boxforkonstantin-max/guitar-stand/DESIGN.md

# Design system

## Direction

Верстак точного столяра при нейтральном дневном свете: темный графит инструмента, холодный синий измерений, фанера как реальный материал модели. Интерфейс плотный и рабочий, без декоративных карточек и рекламных блоков.

## Tokens

- Background: `oklch(0.12 0 0)`
- Surface: `oklch(0.18 0.012 230)`
- Raised surface: `oklch(0.23 0.014 230)`
- Ink: `oklch(0.95 0.006 230)`
- Muted: `oklch(0.72 0.018 230)`
- Primary: `oklch(0.64 0.12 230)`
- Accent: `oklch(0.78 0.15 78)`
- Success: `oklch(0.70 0.14 150)`
- Danger: `oklch(0.66 0.19 28)`

## Typography

Один системный гротеск для интерфейса. Табличные числа включают tabular-nums. Основной размер 14 px, подписи 12 px, заголовок инструмента 18 px.

## Layout

Три рабочие зоны: список деталей слева, 3D-сцена в центре, параметры и проверки справа. На узком экране панели переходят под сцену. Холст остается главным элементом.

## Components

- Toolbar: компактные кнопки 36-40 px, явные активные состояния.
- Part row: код, название, размер и видимость без вложенных карточек.
- Inspector: числовые поля в миллиметрах, статус проверки, координаты выбранной детали.
- Canvas: темный нейтральный фон, реальная сетка 100 мм, оси и размерный куб.

## Motion

Только движение камеры, детали и плавный переход взрыв-схемы. Интерфейсные переходы 160-220 мс; при reduced motion - мгновенно.
