boxforkonstantin-max/guitar-stand/DEPLOYMENT.md

# Публикация конструктора

- 12.10.2026 D3: отдельная исправленная компоновка `/ldsp-onstage/d3.html`, не производственный выпуск. D2 отмечен архивным. Публичный корень предлагает D3 и R6 без автоматического перенаправления.
- Three.js 0.170.0 и два controls включены в `vendor/three` с лицензией MIT; сторонний CDN больше не нужен. Геометрия R6 и app.js не изменены, в HTML исправлены загрузка и ссылки.
- `127.0.0.1:8080` — временный просмотр разработчика, не постоянный хостинг. При диагностике 12.10 локальный порт не отвечал. Для передачи преподавателю использовать публичный HTTPS-адрес.

- Репозиторий: https://github.com/boxforkonstantin-max/guitar-stand
- Выбранный бесплатный хостинг: GitHub Pages, ветка main, корень.
- Ожидаемый адрес: https://boxforkonstantin-max.github.io/guitar-stand/
- Публикуются только код приложения и воспроизводимые файлы геометрии. Исходные пользовательские фотографии, приватные документы, секреты и соседние проекты не входят в Git.
- Статическое приложение; рабочих БД и серверного состояния нет. Откат — точный предыдущий Git commit. Изменения положений в браузере локальны и не сохраняются на сервере.
- R6: по просьбе владельца K и Katana возвращены в горизонтальное положение 0°. AIRSTEP центр Z45, прежний наклон 10°, упор U оставлен. Просвет у педали около 123 мм: удобство не подтверждено. Плашка AUX/USB/наушники 3,5 мм остаётся отложенной.
- Геометрия проекта не является допуском к изготовлению: нужно согласовать вентиляцию, крепёж, устойчивость, фактические габариты и эргономику.
