boxforkonstantin-max/guitar-stand/PRODUCT.md

# Product

## Register

product

## Platform

web

## Users

Владелец домашней гитарной установки, который собирает компактную стойку сам или передает файлы столяру/оператору ЧПУ. Основной сценарий - проверить реальную компоновку, осмотреть изделие со всех сторон и подготовить детали к производству.

## Product Purpose

Дать один проверяемый источник геометрии для стойки под Boss Katana-50 MkII, XSONIC AIRSTEP и 13-дюймовый ноутбук: интерактивную сборку в миллиметрах, ведомость деталей и производственные 2D-файлы.

## Brand Personality

Точный, мастерской, спокойный.

## Anti-references

Не имитировать художественный псевдочертеж, не скрывать допущения, не использовать декоративную «инженерную» графику без числовой геометрии, не превращать интерфейс в маркетинговый лендинг.

## Design Principles

- Один набор параметров управляет визуализацией и производственными файлами.
- Размеры, допуски и непроверенные исходные данные видны рядом с моделью.
- Основные действия доступны без обучения: выбрать, двигать, вращать, вернуть в сборку.
- Раскрой считается в миллиметрах и проходит автоматическую проверку границ и пересечений.
- Ошибка модели оборудования должна обнаруживаться до распила листа.

## Accessibility & Inclusion

Клавиатурная навигация, заметный фокус, достаточный контраст, отключение лишнего движения при prefers-reduced-motion. Цвет не является единственным носителем состояния.
