boxforkonstantin-max/guitar-stand/ldsp-onstage/output-d3/hardware.html

← Модель D3

# Без ящика и больших упаковок крепежа

Цены Крепики прочитаны в каталоге 12.10.2026. Резервы подписаны отдельно. Это бюджет для согласования, не подтверждённый заказ и не окончательная спецификация.

Фурнитура с резервами: 2,305.08 ₽. Вся стойка с работами: 13,420.04 ₽. Без доставки и монтажа к стене.

Позиция | Количество | Сумма, ₽
Конфирмат 7×50, внутренний шестигранник (https://www.krepika.ru/catalog/itempage/6725/)1,98 ₽/шт. Цена в каталоге 12.10.2026. | 34 шт. | 67.32
Саморез 4×30, головка со сферой, PZ (https://www.krepika.ru/catalog/itempage/7312/)1273,96 ₽/кг. Масса 0,002 кг/шт. округлена магазином; итог по весам. | 20 шт. ≈ 0,040 кг | 50.96
Рояльная петля 500 мм (https://1levsha.ru/catalog/mebelnaya_furnitura/7020/)Ссылка на товар в Екатеринбурге. 150 ₽ — бюджет, не подтверждённая цена; присадка HOLD. | 1 шт. / резерв | 150.00
Ограничители откидывания, параВыбрать пару под фасад ~0,6 кг; не газлифт для тяжёлой двери. Присадка HOLD. | резерв | 200.00
Магнитный фиксатор с ответной частьюПрисадка после выбора. Не добавлять отдельную выступающую ручку. | 1 компл. / резерв | 100.00
Мягкие привинчиваемые опоры гитары (https://on-stage.com/guitar-workstation-rosewood)Две нижние опоры и верхний ограничитель. Это референс, НЕ ссылка на покупку. Точный аналог ещё не выбран. | 3 шт. / резерв | 1000.00
Липучка UNIBOB 49310, 20 мм × 1 м (https://lipkaya-lenta.ru/katalog/lipuchki-zastezhki/lenta-lipuchka-unibob-kruchok-petlya-samokleyashayasya.html)Ранее найденная цена, повторно не подтверждена. Для педали; к гитаре не приклеивать. | 1 комплект | 232.80
Подпятники / мягкие накладкиЛокальные подпятники, не рулон резины 6 м. На гитаре — совместимое с лаком заводское покрытие. | резерв | 104.00
Малый крепёж петли, фиксатора и держателей (https://www.krepika.ru/catalog/itempage/1575/)3,5×16 потай: 519 ₽/кг; количество и длины определить по фурнитуре, не покупать 250 шт. | резерв поштучно/весом | 100.00
Страховка от опрокидывания (https://www.krepika.ru/catalog/itempage/66196/)Пример местной цены: RDRp 10×160 — 49,98 ₽/шт. НЕ автоматическая замена SXRL: стена и узел не выбраны. | резерв | 300.00

## Материал и работы

ЛДСП 16 мм, целый лист 2500×1830 | 2130.00 ₽
Распил — бюджет, не заказ цеха | 700.00 ₽
Кромление 23,916 м × 60 ₽ | 1434.96 ₽
Материал кромки — резерв | 450.00 ₽
108 сверлений × 25 ₽ | 2700.00 ₽
Ручки, отверстия новой фурнитуры, доводка — резерв | 1200.00 ₽
Сборка и контрольные испытания — резерв | 2500.00 ₽

## Что исключено

Телескопические направляющие и короб ящика; деревянная вилка, её рёбра и боковая платформа; рулон резины; упаковки по 250 шурупов; пакет шайб на 10 штук.

Для сравнения: DIN 9021 М10 — 3,74 ₽/шт. (https://www.krepika.ru/catalog/itempage/1794/); SXRL T 10×160 — 267,89 ₽/шт. (https://www.krepika.ru/catalog/itempage/48521/) (иная головка, чем прежний FUS). Покупать только выбранное исполнение, не смешивать дюбели и шурупы разных систем.

Ручки — сквозные пазы 110×30 мм, без покупной накладной ручки. Обработать и закрыть торец, снять острые кромки.

## Не закрыто до производства

- Присадка петли, фиксатора, ограничителей и держателей не утверждена: не сверлить по 3D.
- Держатели показаны по принципу On-Stage. Материал оригинала и доступный аналог с паспортом не подтверждены.
- Нужны примерка гитары, выбор фурнитуры и испытания узлов. Это компоновка, не выпуск в производство.
- Без страховки от опрокидывания не эксплуатировать; тип анкера зависит от стены.
- Переносить только пустую стойку вдвоём. Вентиляция отложена.

Размеры, механизм и контрольные условия
