boxforkonstantin-max/guitar-stand/ldsp-onstage/output-d2/hardware.html

← Модель D2

# Фурнитура и стоимость D2

Проверка каталогов: 12 октября 2026. Цены без доставки. Это расчёт бюджета, не счёт поставщика.

Фурнитура: 5,308.07 ₽. С изготовлением и целыми розничными упаковками: 19,712.07 ₽. Сценарий цеха с метизами поштучно: 18,382.95 ₽ — предварительно.

Не оферта. Поштучный отпуск W1 не подтверждён. Перед покупкой сверить цену, упаковку и доставку. Ни один заказ не оформлен.

Позиция / ссылка на товар | Нужно | Покупка | Сумма, ₽
SL · BOYARD DB4501Zn/300, пара (https://www.boyard.biz/catalog/slide_systems/db4501zn-300.html)15 кг на пару по текущей карточке. Не 40 кг из старого каталога. В Екатеринбурге наличие не подтверждено. | 1 | 1 пара | 275.97
C7 · Конфирмат 7×50 Timtech (https://www.ozon.ru/product/konfirmat-7h50-mm-10sht-mebelnyy-vint-styazhka-golovka-potaynaya-pod-shestigrannik-evrovint-1317687131/)93 ₽ за 10 шт., цена без специальной банковской скидки; остаток в запас. | 52 | 6 пакетов по 10 | 558.00
S4 · Шуруп по дереву 4×30 PZ2, полукруглая головка (https://letfix.ru/shop/fasteners/screws/screws_for_wood_polukr_yzn_4x30.html)Артикул 106001817. Цеху выгоднее отпустить 28 шт. из своей упаковки; их доля 114,24 ₽. Не заменять головку без изменения чертежа. | 28 | 250 шт. | 1020.00
S16 · Шуруп по дереву 3,5×16 PZ2, полукруглая головка (https://letfix.ru/shop/fasteners/screws/screws_for_wood_polukr_yzn_3-5x16.html)Артикул 106001802. Доля 10 шт. — 17,64 ₽. Проверить зазор головки в направляющей. | 10 | 250 шт. | 441.00
STR · Fortisflex КСВ 16×310 чёрный, 59295 (https://www.radioelementy.ru/catalog/pod-zakaz/styazhka-velkro-ksv-16kh310-chern-fortisflex-59295/)39,89 ₽/шт. Один ремень вилки, восемь для кабелей. Не несущая подвеска гитары. | 9 | 20 шт. | 797.80
VEL · UNIBOB 49310, крючок+петля 20 мм × 1 м (https://lipkaya-lenta.ru/katalog/lipuchki-zastezhki/lenta-lipuchka-unibob-kruchok-petlya-samokleyashayasya.html)2 полосы по 200 мм под AIRSTEP; остальные 600 мм в запас. Не закрывать серийный номер/винты прибора. | 1 | 1 комплект | 232.80
FEL · Pacific РС6055BR, войлок 3 мм, 35×55, 12 шт. (https://amix.biz/catalog/nozhki_mebelnye/podpyatniki_mebelnye/rs6055br/)52 ₽/лист. По 3 накладки на G1/G2, 6 подрезанных накладок по контуру вилки. Стыки без открытой кромки; сначала проба совместимости с лаком. | 12 | 2 листа / 24 накладки | 104.00
RUB · Резиновая самоклеящаяся полоса 29×3 мм, 6 м (https://m.integration.vs.market.yandex.net/card/samokleyashchayasya-rezinovaya-taktilnaya-polosa-protiv-skolzheniya-29-mm-kh-3-mm-tsvet-seryy-dlina-6-metrov/1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)Цена с Яндекс Пэй. 4 полосы 834 мм под E1/E2 (нахлёст по ширине обрезать), 2 по 500 под PF1/PF2. Остаток 1664 мм. Не использовать эту резину на гитаре. | 1 | 1 рулон | 1222.00
W1 · fischer SXRL 10×160 FUS, 522724 (https://fischersystem.ru/catalog/fasadnye_dyubeli/522724/)289,25 ₽/шт. Каталог также указывает коробку 50 шт. за 14 462,49 ₽. Не заказывать коробку ради двух: стоимость 2 шт. условна до подтверждения отпуска. Только узел для бетона C20/25. | 2 | 2 шт. / проверить поштучную продажу | 578.50
W2 · Шайба DIN 9021 M10, оцинкованная (https://www.stroysa.tomsk.ru/catalog/metrika/shayba_din_9021_uvelichennaya_m10_10sht/)78 ₽ без карты; Øнаружный 30, Øвнутренний 10,5, толщина 2,5 мм. Под головками стеновых креплений. | 2 | 10 шт. | 78.00

## Материалы и работы

ЛДСП белый 16 мм, 2500×1830, 1 лист (https://twowin.ru/product/ldsp-16mm-2500kh1830-belyy-0110-resm-kronoshpan/) | 2130.00 ₽
Раскрой 30 деталей ЛДСП 16 мм (https://family96.ru/raspil-ldsp/)Тариф 21–40 деталей; малые W выпиливать из укрупнённой заготовки безопасным способом. | 700.00 ₽
Кромление всех деталей 16 мм (https://family96.ru/raspil-ldsp/)Расчётная оценка: 60 ₽/м; фасонные торцы цех считает отдельно. | 2024.00 ₽
Материал кромки 0,4 мм + герметизация пазовРезерв, не найденная розничная цена. Включить в предложение цеха. | 600.00 ₽
Присадка всех отверстий (https://drevplit96.ru/services/raspil/)Оценка по тарифу от 25 ₽/отверстие, торцевые и зенковки могут стоить иначе. | 4450.00 ₽
Фрезеровка вилки, ручки и трёх пазовБюджетный резерв на ЧПУ/шаблон, не коммерческое предложение. | 2000.00 ₽
Сборка и контрольные испытания образцаРезерв; монтаж анкеров и доставка отдельно. | 2500.00 ₽

## Сборка без лишних покупок

Отдельные ручка, петли, газлифт и доводчик не нужны. Ручка фрезерована в фасаде. Направляющие имеют полный ход и рычаги снятия. Площадка AIRSTEP снимается руками и работает на полу.

Сменная плашка прежней версии удалена: теперь есть нижние опоры гитары, вилка и ремешок. Подвешивать вес гитары к вилке нельзя.

Обязательная страховка от опрокидывания: два анкера через верхнюю заднюю связь и прокладки. Чертёж подходит только для здорового бетона C20/25; для другой стены требуется другой монтажный узел.

Не включены: доставка, монтаж в стену, инструменты/оснастка изготовителя, техника/гитара, необязательные органайзеры.

Чертежи и контрольная сборка · Исходные суммы
