boxforkonstantin-max/guitar-stand/output/guitar_stand_drawings.pdf

# Раскрой двух стоек / 01 · Плавная дуга

Лист 2440 × 1220 × 18. Отступ 6; зазор между габаритами ≥6. Без зеркалирования.

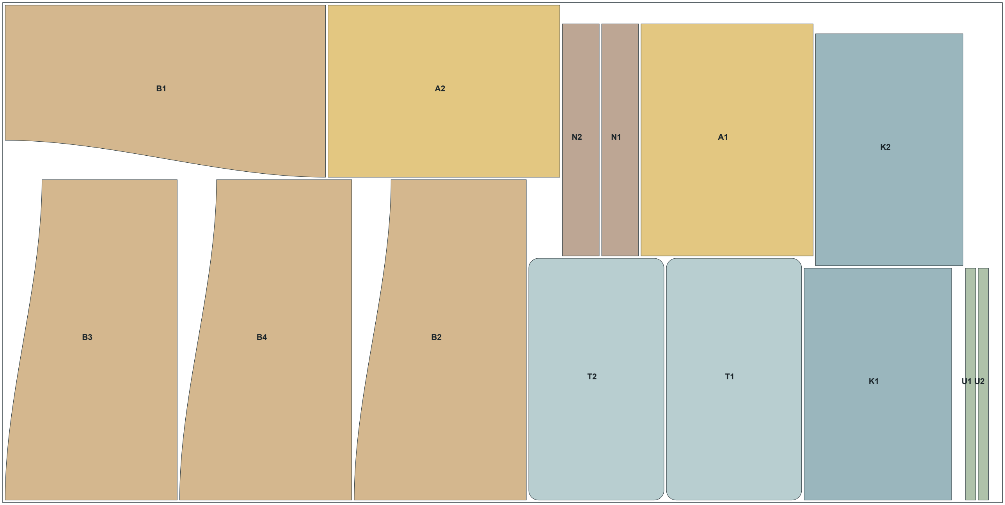
[picture p1: figure]

R6 • Горизонтальная полка Katana, не выпуск в производство • мм • лист 1

14 деталей с передними упорами; использование листа 86.49%. Один лист на два изделия.

Это раскрой внешних контуров. Пазы, крепёж и отверстия для кабелей не включены в слой CUT.

Зазор 6 мм требует согласования инструмента и стратегии CAM; припуск на чистовую обработку не заложен.

# Геометрия деталей и варианты дизайна

Все три варианта имеют одинаковые габариты и посадочные отметки. Толщина 18 мм.

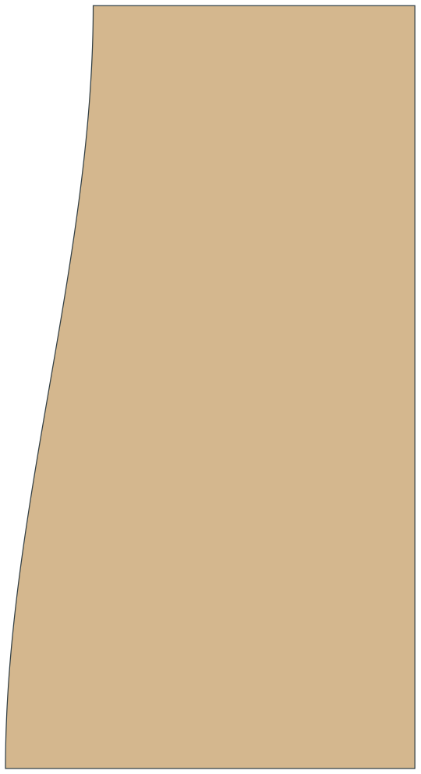
[picture p2: figure]
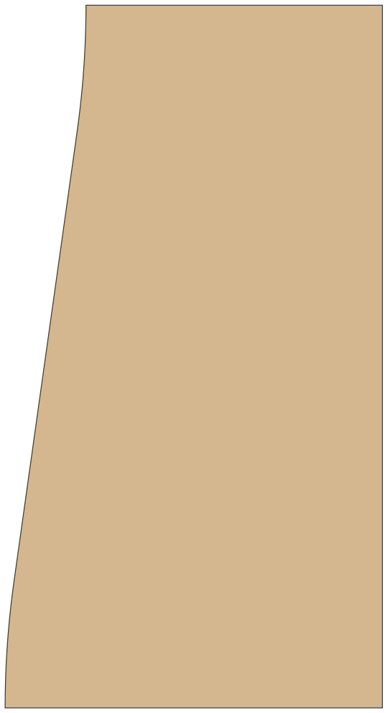
[picture p3: figure]

R6 • Горизонтальная полка Katana, не выпуск в производство • мм • лист 2

01 · Плавная дуга

Низ 420 / верх 330 / высота 782

02 · Прямая с мягкими концами

Низ 420 / верх 330 / высота 782

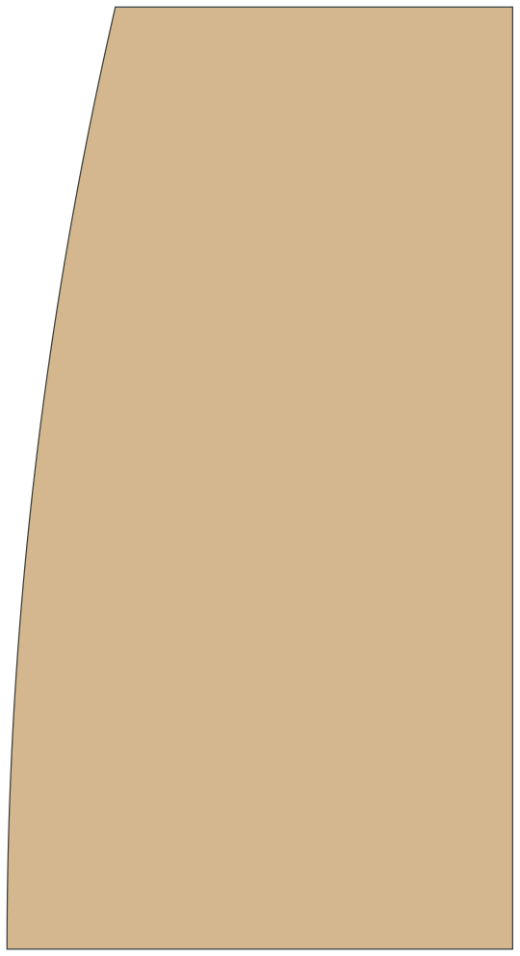
[picture p4: figure]

03 · Скульптурная дуга

Низ 420 / верх 330 / высота 782

## Ведомость на 2 изделия

B: 420 × 782 × 18 / 4 шт.

T: 590 × 330 × 18 / 2 шт.

K: 566 × 360 × 18 / 2 шт.

A: 566 × 420 × 18 / 2 шт.

N: 566 × 90 × 18 / 2 шт.

U: 566 × 25 × 18 / 2 шт.

T: скругление всех углов R24.

Боковина 782 + столешница 18 = общая высота 800.

Чистый пролёт 554 мм; детали K/A/N 566 мм рассчитаны на заход по 6 мм в боковины.

Пазы и соединения требуют отдельной деталировки по фактической толщине фанеры с покрытием.

Полилиния передней кромки: 160 сегментов. Координаты одинаковы в модели, SVG и DXF.

# Сборка / положение полок

Слева: вид спереди. Справа: вид сбоку, передняя кромка слева. Оборудование условное.

R6 • Горизонтальная полка Katana, не выпуск в производство • мм • лист 3

### Ширина 590 / высота 800

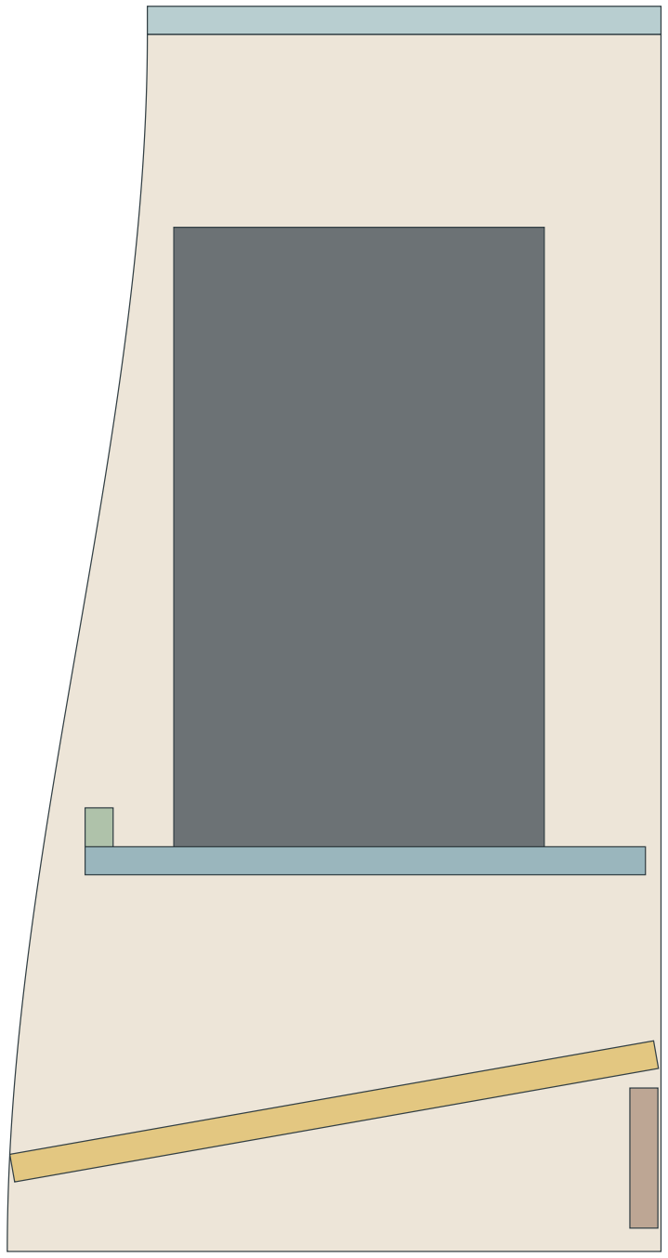
[picture p5: figure]

T

K

A

N

U

### Глубины: A 420 → K 360 → T 330

T верх 800; K горизонтальная, верх Y260; A центр Y90, наклон 10°; упор U 25 мм.

Оси сборки: X ширина, Y высота, Z от передней кромки к задней. Координаты центров - в model.json.

# Кабели и ограничения проекта

Отверстия ниже - предложения, не обязательная обработка. Точные модели оборудования нужно подтвердить.

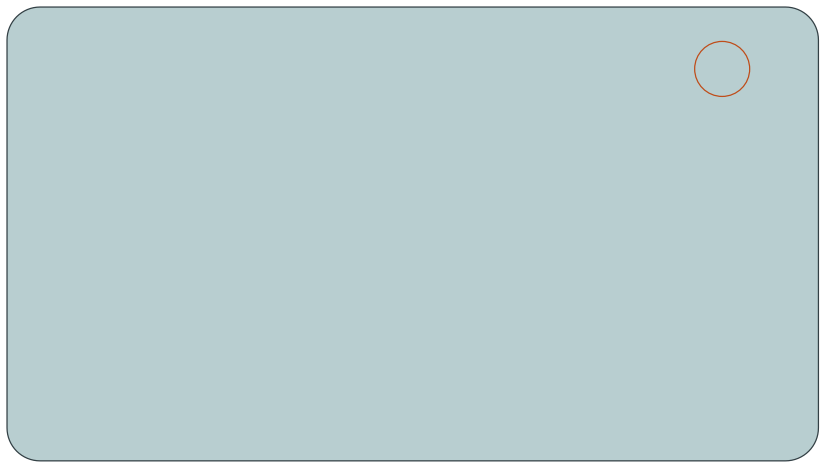
[picture p6: figure]

R6 • Горизонтальная полка Katana, не выпуск в производство • мм • лист 4

### T: Ø40, центр 520 / 285

От левого переднего угла, вид сверху.

### K: Ø40, центр 505 / 315

От левого переднего угла, вид сверху.

### A: Ø40, центр 495 / 365

От левого переднего угла, вид сверху.

Клипсы на внутренней стороне правой боковины: задняя зона Z≈380 мм; окончательные места после примерки.

Запас сигнального кабеля - на липучке под K. Не перекрывать задние отверстия усилителя.

Сетевой кабель вести отдельно от аудиолинии; отверстия защитить втулками, не делать перегиб у штекера.

Katana-50 MkII: AC IN, USB-B, AUX IN, FOOT CONTROL/EXP, PHONES/REC OUT, POWER AMP IN.

AIRSTEP Kat Edition: USB-C → USB-B Katana. Разъёмы схематичны, координаты не обмерены.

ВАЖНО: руководство BOSS требует 200 мм по бокам, 300 мм сверху, 150 мм сзади, 50 мм спереди.

R6: по бокам 42 мм; над верхним габаритом Katana 124 мм. Доступ к ручкам требует примерки.

Эти зазоры меньше инструкции. Нельзя считать проект согласованным для эксплуатации усилителя.

AIRSTEP сдвинут вперёд: до продолжения низа K около 123 мм. Удобство ноги требует примерки.

Источник: BOSS KATANA MkII Owner’s Manual, разделы размещения и задней панели. (https://static.roland.com/assets/media/pdf/KTN-Mk2_eng02_W.pdf)

XSONIC: xsonicaudio.com/pages/airstepkatedition. Портовая схема не является сверловочным шаблоном.
