boxforkonstantin-max/guitar-stand/ldsp-onstage/output-d3/review.pdf

### WORKSTATION D3 / ИСПРАВЛЕННАЯ КОМПОНОВКА / 12.10.2026

# D3: дверца, съёмная площадка, мягкие держатели

HOLD: не передавать в производство до подбора фурнитуры и проверки её присадки. Размеры мм. | 1

Корпус 654 x 360 x 800; закрытый фасад выступает вперёд на 18. Опоры гитары выступают вправо на 120.

Старый R6 и прежние D1/D2 сохранены. D2 отклонён владельцем, его чертежи не актуальны для D3.

15 деталей ЛДСП 16; 34 конфирмата 7x50 и 20 саморезов 4x30 в основных соединениях.

Ручки в L/R: сквозные пазы 110x30, R15, центр u175 / v680. Чистовой верх Y711.

Полка Katana горизонтальная, верх Y236; усилитель 470x398x238, масса 11,6 кг.

Столешница Y800, ноутбук Air 15 помещается. До низа столешницы над Katana 150 мм.

AIRSTEP Kat 300x45x70, 0,65 кг; площадка PB 500x220x16, верх в отсеке Y64.

Откидная дверца F 618x100x16; ось поворота X, Y34, Z-2. Рабочий угол 0..90 градусов.

Новые покупные узлы пока не имеют подтверждённой присадки. Их отверстия НЕ выдуманы в DXF.

Сверления корпуса и контуры показаны для проверки. Для полного заказа этого комплекта недостаточно.

Присадка петли, фиксатора, ограничителей и держателей не утверждена: не сверлить по 3D.

Держатели показаны по принципу On-Stage. Материал оригинала и доступный аналог с паспортом не подтверждены.

Нужны примерка гитары, выбор фурнитуры и испытания узлов. Это компоновка, не выпуск в производство.

Без страховки от опрокидывания не эксплуатировать; тип анкера зависит от стены.

Переносить только пустую стойку вдвоём. Вентиляция отложена.

# Нижний отсек: последовательность без телескопического ящика

HOLD: не передавать в производство до подбора фурнитуры и проверки её присадки. Размеры мм. | 2
1. Потянуть за прорезь фасада. Опустить на 90 градусов, удерживая рукой; не бросать вниз.
2. Петля 500 мм вдоль нижней кромки; два ограничителя хода, один магнитный фиксатор закрытия.
3. Приподнять площадку на 10 мм, вытащить на 430 мм вперёд; затем поставить на пол.
4. На площадке нет боковин ящика. Нажимать педаль только на полу, не на открытом фасаде.
5. В обратном порядке вернуть площадку, уложить кабель и поднять фасад. Кабель не зажимать петлёй.

Проверка кинематики: 91 положение дверцы. Минимум до пола 18 мм; дверца остаётся перед корпусом.

При вынимании: низ ножек Y42, верх открытого фасада Y34 - зазор 8 мм.

Верх AIRSTEP при подъёме Y119; низ переднего ребра Y140 - зазор 21 мм.

Показанная ось требует соответствующей установки петли. Сначала примерить петлю к образцу ЛДСП 16.

Шаблон отверстий, тип ограничителей и их длина - HOLD. Этот лист не задаёт ложную заводскую присадку.

Закрыто | Фасад вниз | Площадка вынута

# Гитара: принцип оригинала, без деревянной вилки

HOLD: не передавать в производство до подбора фурнитуры и проверки её присадки. Размеры мм. | 3

Две нижние мягкие консоли: опорные оси Y100, Z110 и Z285, вылет 120 мм от боковины X654.

Верхний мягкий ограничитель: ось Y760, Z180, вылет 115 мм; две мягкие ограничительные шайбы.

Форма воспроизведена по крупным фото производителя, а не по чужому рисунку.

Производитель не указал марку пластика: утверждать, что это именно полиэтилен, нельзя.

Выбранного покупного аналога с чертежом крепления пока нет. Резерв на три держателя 1000 .

Не заменять нижние опоры обычными крючками за гриф: другая нагрузка и другая геометрия.

Рекомендуемая схема крепления к ЛДСП: сквозной болт с широкой шайбой/ответной пластиной,

а не длинный шуруп в 16-мм плиту. Диаметр и присадка - только по выбранному держателю.

Расчётное требование при 5 кг и плече 90 мм: до 4,42 Нм на одну нижнюю опору при неравномерности.

Гриф только ограничивается от выпадения. Две нижние опоры несут массу; нужен удерживающий ремешок.

Контактные накладки должны быть совместимы с лаком гитары. Никакой бытовой резины с неизвестным составом.

Примерка и проба эквивалентом груза обязательны до использования настоящей гитары.

Фото верхнего ограничителя On-Stage (ссылка) (https://on-stage.com/images/products/98739/48143/800x800/TMP-GWS5000RB.jpg)

Фото нижней мягкой опоры On-Stage (ссылка) (https://on-stage.com/images/products/98739/48144/800x800/TMP-GWS5000RB.jpg)

# Устойчивость и ограничения нагрузки

HOLD: не передавать в производство до подбора фурнитуры и проверки её присадки. Размеры мм. | 4

Опоры пола X0..654, Z20..340. Плотность ЛДСП принята 600 кг/м³; масса фурнитуры не учитывается.

Скрининговый расчёт, не сертификация: Fкр = восстанавливающий момент / 0,8 м.

Без Katana устойчивость против толчка 50 Н сверху не обеспечена. Страховка обязательна.

Полка K: одна вертикальная балка 16x80 с пролётом 622 несёт 20 кг по консервативной схеме.

Напряжение 1.788 МПа; условный длительный прогиб 2.702 мм.

Для фактической плиты нужно подтвердить E>=1600 МПа и прочность изгиба >=11 МПа.

Педалборд: расчётное усилие нажатия 300 Н, только на полу. Это не ступенька.

Ручки: переносить пустой корпус вдвоём, не стойку с усилителем и гитарой. Прочность вырезов не испытана.

Katana / гитара / дверца / площадка на полу | Масса, кг | Fкр вперёд / вправо, Н
amp0_guitar0_open0_floor0 | 18.45 | 36.2 / 74.0
amp0_guitar0_open1_floor0 | 18.45 | 35.9 / 74.0
amp0_guitar0_open1_floor1 | 16.43 | 32.4 / 65.9
amp0_guitar1_open0_floor0 | 23.45 | 46.0 / 70.2
amp0_guitar1_open1_floor0 | 23.45 | 45.7 / 70.2
amp0_guitar1_open1_floor1 | 21.43 | 42.2 / 62.1
amp1_guitar0_open0_floor0 | 30.05 | 56.7 / 120.5
amp1_guitar0_open1_floor0 | 30.05 | 56.4 / 120.5
amp1_guitar0_open1_floor1 | 28.03 | 52.9 / 112.4
amp1_guitar1_open0_floor0 | 35.05 | 66.5 / 116.7
amp1_guitar1_open1_floor0 | 35.05 | 66.2 / 116.7
amp1_guitar1_open1_floor1 | 33.03 | 62.7 / 108.6

# Смета: поштучно и на вес, без лишних упаковок

HOLD: не передавать в производство до подбора фурнитуры и проверки её присадки. Размеры мм. | 5

Фурнитура с явно указанными резервами: 2305.08 . Общий предварительный бюджет: 13420.04 .

Доставка и монтаж к стене не включены; это не котировка цеха и не окончательная цена изделия.

Крепика: 34 конфирмата x 1,98 = 67,32 ; 20 саморезов x ~0,002 кг x 1273,96 = ~50,96 .

Сумма весовых позиций ориентировочная: масса в карточке округлена, оплату определят весы магазина.

Шайбы DIN 9021 М10: 3,74 /шт.; фасадные дюбели тоже есть поштучно. Упаковка не нужна.

В актуальную смету не входит рулон резины, большие пачки саморезов или направляющие ящика.

Точные ссылки, суммы по позициям и различие цены/резерва - в hardware.html.

Конфирмат 7×50, внутренний шестигранник (https://www.krepika.ru/catalog/itempage/6725/) | 34 шт. | 67.32
Саморез 4×30, головка со сферой, PZ (https://www.krepika.ru/catalog/itempage/7312/) | 20 шт. ≈ 0,040 кг | 50.96
Рояльная петля 500 мм (https://1levsha.ru/catalog/mebelnaya_furnitura/7020/) | 1 шт. / резерв | 150.00
Ограничители откидывания, пара | резерв | 200.00
Магнитный фиксатор с ответной частью | 1 компл. / резерв | 100.00
Мягкие привинчиваемые опоры гитары (https://on-stage.com/guitar-workstation-rosewood) | 3 шт. / резерв | 1000.00
Липучка UNIBOB 49310, 20 мм × 1 м (https://lipkaya-lenta.ru/katalog/lipuchki-zastezhki/lenta-lipuchka-unibob-kruchok-petlya-samokleyashayasya.html) | 1 комплект | 232.80
Подпятники / мягкие накладки | резерв | 104.00
Малый крепёж петли, фиксатора и держателей (https://www.krepika.ru/catalog/itempage/1575/) | резерв поштучно/весом | 100.00
Страховка от опрокидывания (https://www.krepika.ru/catalog/itempage/66196/) | резерв | 300.00

# L / Боковина левая / 360 x 768 x 16

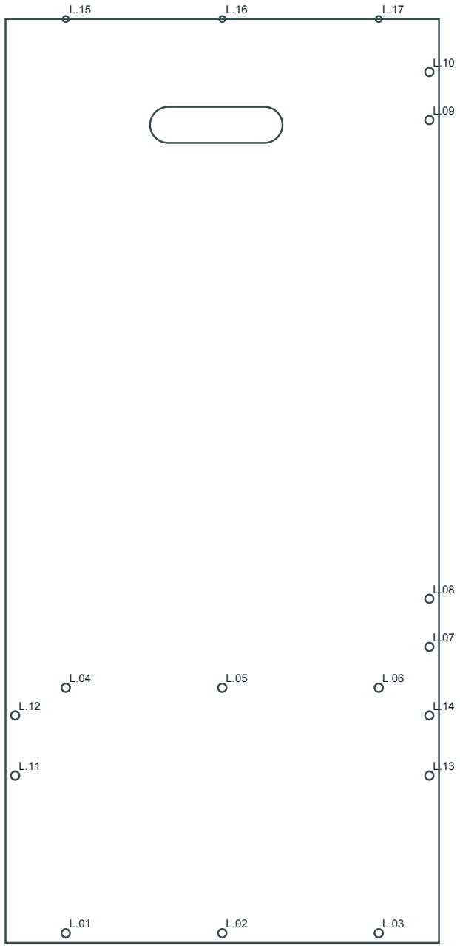
[picture p11: figure]

HOLD: не передавать в производство до подбора фурнитуры и проверки её присадки. Размеры мм. | 6
ID | u | v | n | Ø | глубина | направление
L.01 | 50 | 8 | 0 | 7 | 16 | [0, 0, 1]
L.02 | 180 | 8 | 0 | 7 | 16 | [0, 0, 1]
L.03 | 310 | 8 | 0 | 7 | 16 | [0, 0, 1]
L.04 | 50 | 212 | 0 | 7 | 16 | [0, 0, 1]
L.05 | 180 | 212 | 0 | 7 | 16 | [0, 0, 1]
L.06 | 310 | 212 | 0 | 7 | 16 | [0, 0, 1]
L.07 | 352 | 246 | 0 | 7 | 16 | [0, 0, 1]
L.08 | 352 | 286 | 0 | 7 | 16 | [0, 0, 1]
L.09 | 352 | 684 | 0 | 7 | 16 | [0, 0, 1]
L.10 | 352 | 724 | 0 | 7 | 16 | [0, 0, 1]
L.11 | 8 | 139 | 0 | 7 | 16 | [0, 0, 1]
L.12 | 8 | 189 | 0 | 7 | 16 | [0, 0, 1]
L.13 | 352 | 139 | 0 | 7 | 16 | [0, 0, 1]
L.14 | 352 | 189 | 0 | 7 | 16 | [0, 0, 1]
L.15 | 50 | 768 | 8 | 5 | 38 | [0, -1, 0]
L.16 | 180 | 768 | 8 | 5 | 38 | [0, -1, 0]
L.17 | 310 | 768 | 8 | 5 | 38 | [0, -1, 0]

Паз: центр (175; 680), 110x30, R15.0

u вправо, v вверх. n - толщина. Начало в чистовом углу детали; направления в таблице локальные.

Покупная фурнитура: присадка HOLD. Контур после кромки 0,4 мм; распил прямоугольника -0,8 мм по обеим осям.

Отверстия конфирмата в головной детали: фаска Ø10 x 1,5; сверить с фактической головкой до серии.

# R / Боковина правая / 360 x 768 x 16

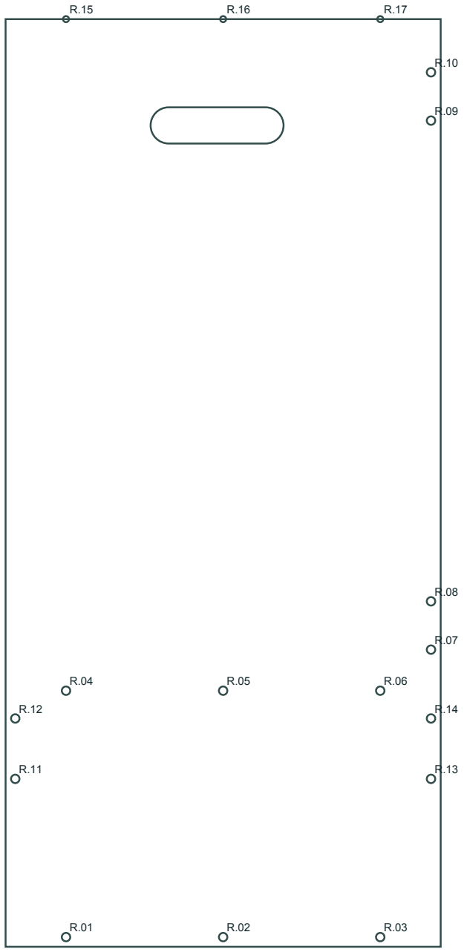
[picture p12: figure]

HOLD: не передавать в производство до подбора фурнитуры и проверки её присадки. Размеры мм. | 7
ID | u | v | n | Ø | глубина | направление
R.01 | 50 | 8 | 16 | 7 | 16 | [0, 0, -1]
R.02 | 180 | 8 | 16 | 7 | 16 | [0, 0, -1]
R.03 | 310 | 8 | 16 | 7 | 16 | [0, 0, -1]
R.04 | 50 | 212 | 16 | 7 | 16 | [0, 0, -1]
R.05 | 180 | 212 | 16 | 7 | 16 | [0, 0, -1]
R.06 | 310 | 212 | 16 | 7 | 16 | [0, 0, -1]
R.07 | 352 | 246 | 16 | 7 | 16 | [0, 0, -1]
R.08 | 352 | 286 | 16 | 7 | 16 | [0, 0, -1]
R.09 | 352 | 684 | 16 | 7 | 16 | [0, 0, -1]
R.10 | 352 | 724 | 16 | 7 | 16 | [0, 0, -1]
R.11 | 8 | 139 | 16 | 7 | 16 | [0, 0, -1]
R.12 | 8 | 189 | 16 | 7 | 16 | [0, 0, -1]
R.13 | 352 | 139 | 16 | 7 | 16 | [0, 0, -1]
R.14 | 352 | 189 | 16 | 7 | 16 | [0, 0, -1]
R.15 | 50 | 768 | 8 | 5 | 38 | [0, -1, 0]
R.16 | 180 | 768 | 8 | 5 | 38 | [0, -1, 0]
R.17 | 310 | 768 | 8 | 5 | 38 | [0, -1, 0]

Паз: центр (175; 680), 110x30, R15.0

u вправо, v вверх. n - толщина. Начало в чистовом углу детали; направления в таблице локальные.

Покупная фурнитура: присадка HOLD. Контур после кромки 0,4 мм; распил прямоугольника -0,8 мм по обеим осям.

# T / Столешница ноутбука / 654 x 360 x 16

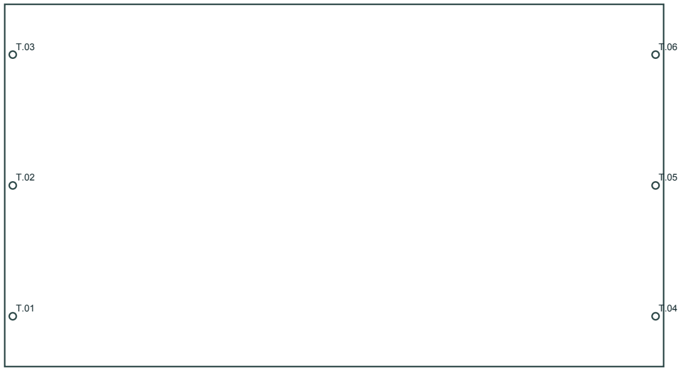
[picture p13: figure]

HOLD: не передавать в производство до подбора фурнитуры и проверки её присадки. Размеры мм. | 8
ID | u | v | n | Ø | глубина | направление
T.01 | 8 | 50 | 16 | 7 | 16 | [0, 0, -1]
T.02 | 8 | 180 | 16 | 7 | 16 | [0, 0, -1]
T.03 | 8 | 310 | 16 | 7 | 16 | [0, 0, -1]
T.04 | 646 | 50 | 16 | 7 | 16 | [0, 0, -1]
T.05 | 646 | 180 | 16 | 7 | 16 | [0, 0, -1]
T.06 | 646 | 310 | 16 | 7 | 16 | [0, 0, -1]

u вправо, v вверх. n - толщина. Начало в чистовом углу детали; направления в таблице локальные.

Покупная фурнитура: присадка HOLD. Контур после кромки 0,4 мм; распил прямоугольника -0,8 мм по обеим осям.

# D / Дно корпуса / 622 x 360 x 16

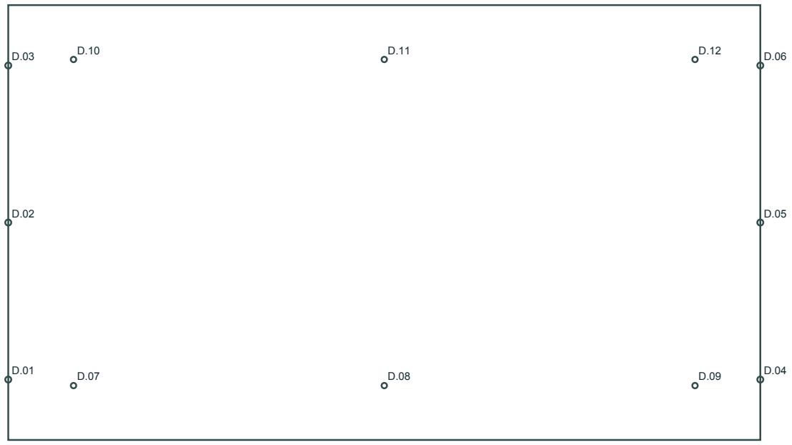
[picture p14: figure]

HOLD: не передавать в производство до подбора фурнитуры и проверки её присадки. Размеры мм. | 9
ID | u | v | n | Ø | глубина | направление
D.01 | 0 | 50 | 8 | 5 | 38 | [1, 0, 0]
D.02 | 0 | 180 | 8 | 5 | 38 | [1, 0, 0]
D.03 | 0 | 310 | 8 | 5 | 38 | [1, 0, 0]
D.04 | 622 | 50 | 8 | 5 | 38 | [-1, 0, 0]
D.05 | 622 | 180 | 8 | 5 | 38 | [-1, 0, 0]
D.06 | 622 | 310 | 8 | 5 | 38 | [-1, 0, 0]
D.07 | 54 | 45 | 16 | 4.5 | 16 | [0, 0, -1]
D.08 | 311 | 45 | 16 | 4.5 | 16 | [0, 0, -1]
D.09 | 568 | 45 | 16 | 4.5 | 16 | [0, 0, -1]
D.10 | 54 | 315 | 16 | 4.5 | 16 | [0, 0, -1]
D.11 | 311 | 315 | 16 | 4.5 | 16 | [0, 0, -1]
D.12 | 568 | 315 | 16 | 4.5 | 16 | [0, 0, -1]

u вправо, v вверх. n - толщина. Начало в чистовом углу детали; направления в таблице локальные.

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

# K / Полка Katana / 622 x 360 x 16

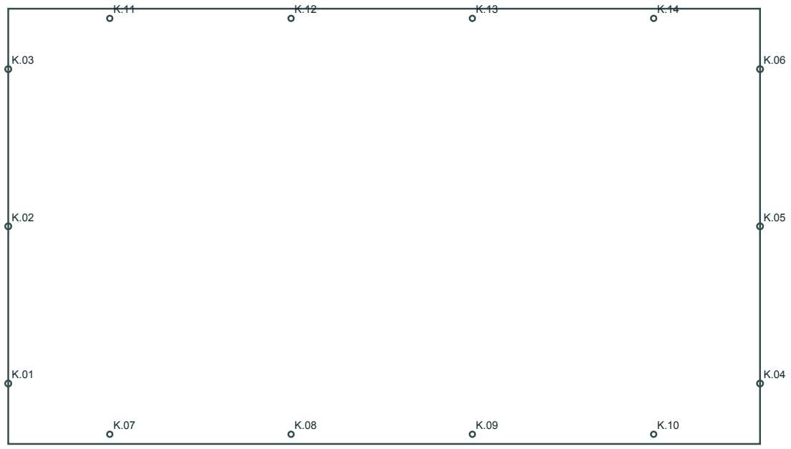
[picture p15: figure]

HOLD: не передавать в производство до подбора фурнитуры и проверки её присадки. Размеры мм. | 10
ID | u | v | n | Ø | глубина | направление
K.01 | 0 | 50 | 8 | 5 | 38 | [1, 0, 0]
K.02 | 0 | 180 | 8 | 5 | 38 | [1, 0, 0]
K.03 | 0 | 310 | 8 | 5 | 38 | [1, 0, 0]
K.04 | 622 | 50 | 8 | 5 | 38 | [-1, 0, 0]
K.05 | 622 | 180 | 8 | 5 | 38 | [-1, 0, 0]
K.06 | 622 | 310 | 8 | 5 | 38 | [-1, 0, 0]
K.07 | 84 | 8 | 16 | 4.5 | 16 | [0, 0, -1]
K.08 | 234 | 8 | 16 | 4.5 | 16 | [0, 0, -1]
K.09 | 384 | 8 | 16 | 4.5 | 16 | [0, 0, -1]
K.10 | 534 | 8 | 16 | 4.5 | 16 | [0, 0, -1]
K.11 | 84 | 352 | 16 | 4.5 | 16 | [0, 0, -1]
K.12 | 234 | 352 | 16 | 4.5 | 16 | [0, 0, -1]
K.13 | 384 | 352 | 16 | 4.5 | 16 | [0, 0, -1]
K.14 | 534 | 352 | 16 | 4.5 | 16 | [0, 0, -1]

u вправо, v вверх. n - толщина. Начало в чистовом углу детали; направления в таблице локальные.

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

# KF / Переднее ребро полки / 622 x 80 x 16

HOLD: не передавать в производство до подбора фурнитуры и проверки её присадки. Размеры мм. | 11

KF.01

KF.02

KF.03

KF.04

KF.05 | KF.06 | KF.07 | KF.08
ID | u | v | n | Ø | глубина | направление
KF.01 | 0 | 15 | 8 | 5 | 38 | [1, 0, 0]
KF.02 | 0 | 65 | 8 | 5 | 38 | [1, 0, 0]
KF.03 | 622 | 15 | 8 | 5 | 38 | [-1, 0, 0]
KF.04 | 622 | 65 | 8 | 5 | 38 | [-1, 0, 0]
KF.05 | 84 | 80 | 8 | 2.5 | 12 | [0, -1, 0]
KF.06 | 234 | 80 | 8 | 2.5 | 12 | [0, -1, 0]
KF.07 | 384 | 80 | 8 | 2.5 | 12 | [0, -1, 0]
KF.08 | 534 | 80 | 8 | 2.5 | 12 | [0, -1, 0]

u вправо, v вверх. n - толщина. Начало в чистовом углу детали; направления в таблице локальные.

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

# KR / Заднее ребро полки / 622 x 80 x 16

HOLD: не передавать в производство до подбора фурнитуры и проверки её присадки. Размеры мм. | 12

KR.01

KR.02

KR.03

KR.04

KR.05 | KR.06 | KR.07 | KR.08
ID | u | v | n | Ø | глубина | направление
KR.01 | 0 | 15 | 8 | 5 | 38 | [1, 0, 0]
KR.02 | 0 | 65 | 8 | 5 | 38 | [1, 0, 0]
KR.03 | 622 | 15 | 8 | 5 | 38 | [-1, 0, 0]
KR.04 | 622 | 65 | 8 | 5 | 38 | [-1, 0, 0]
KR.05 | 84 | 80 | 8 | 2.5 | 12 | [0, -1, 0]
KR.06 | 234 | 80 | 8 | 2.5 | 12 | [0, -1, 0]
KR.07 | 384 | 80 | 8 | 2.5 | 12 | [0, -1, 0]
KR.08 | 534 | 80 | 8 | 2.5 | 12 | [0, -1, 0]

u вправо, v вверх. n - толщина. Начало в чистовом углу детали; направления в таблице локальные.

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

# V / Нижняя задняя связь / 622 x 80 x 16

HOLD: не передавать в производство до подбора фурнитуры и проверки её присадки. Размеры мм. | 13

V.01

V.02

V.03

V.04

ID | u | v | n | Ø | глубина | направление
V.01 | 0 | 20 | 8 | 5 | 38 | [1, 0, 0]
V.02 | 0 | 60 | 8 | 5 | 38 | [1, 0, 0]
V.03 | 622 | 20 | 8 | 5 | 38 | [-1, 0, 0]
V.04 | 622 | 60 | 8 | 5 | 38 | [-1, 0, 0]

u вправо, v вверх. n - толщина. Начало в чистовом углу детали; направления в таблице локальные.

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

# U / Верхняя задняя связь / 622 x 80 x 16

HOLD: не передавать в производство до подбора фурнитуры и проверки её присадки. Размеры мм. | 14

U.03

U.04

U.05

U.06

ID | u | v | n | Ø | глубина | направление
U.03 | 0 | 20 | 8 | 5 | 38 | [1, 0, 0]
U.04 | 0 | 60 | 8 | 5 | 38 | [1, 0, 0]
U.05 | 622 | 20 | 8 | 5 | 38 | [-1, 0, 0]
U.06 | 622 | 60 | 8 | 5 | 38 | [-1, 0, 0]

u вправо, v вверх. n - толщина. Начало в чистовом углу детали; направления в таблице локальные.

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

# E1 / Опорная планка корпуса / 654 x 50 x 16

HOLD: не передавать в производство до подбора фурнитуры и проверки её присадки. Размеры мм. | 15
E1.01 | E1.02 | E1.03
ID | u | v | n | Ø | глубина | направление
E1.01 | 70 | 25 | 16 | 2.5 | 12 | [0, 0, -1]
E1.02 | 327 | 25 | 16 | 2.5 | 12 | [0, 0, -1]
E1.03 | 584 | 25 | 16 | 2.5 | 12 | [0, 0, -1]

u вправо, v вверх. n - толщина. Начало в чистовом углу детали; направления в таблице локальные.

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

# E2 / Опорная планка корпуса / 654 x 50 x 16

HOLD: не передавать в производство до подбора фурнитуры и проверки её присадки. Размеры мм. | 16
E2.01 | E2.02 | E2.03
ID | u | v | n | Ø | глубина | направление
E2.01 | 70 | 25 | 16 | 2.5 | 12 | [0, 0, -1]
E2.02 | 327 | 25 | 16 | 2.5 | 12 | [0, 0, -1]
E2.03 | 584 | 25 | 16 | 2.5 | 12 | [0, 0, -1]

u вправо, v вверх. n - толщина. Начало в чистовом углу детали; направления в таблице локальные.

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

# F / Откидная нижняя дверца / 618 x 100 x 16

HOLD: не передавать в производство до подбора фурнитуры и проверки её присадки. Размеры мм. | 17
ID | u | v | n | Ø | глубина | направление

Паз: центр (309; 72), 110x24, R12.0

u вправо, v вверх. n - толщина. Начало в чистовом углу детали; направления в таблице локальные.

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

# PB / Съёмная площадка AIRSTEP / 500 x 220 x 16

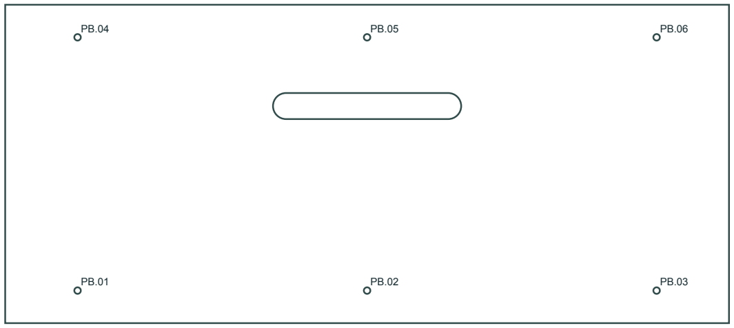
[picture p16: figure]

HOLD: не передавать в производство до подбора фурнитуры и проверки её присадки. Размеры мм. | 18
ID | u | v | n | Ø | глубина | направление
PB.01 | 50.0 | 22.5 | 16.0 | 4.5 | 16 | [0, 0, -1]
PB.02 | 250.0 | 22.5 | 16.0 | 4.5 | 16 | [0, 0, -1]
PB.03 | 450.0 | 22.5 | 16.0 | 4.5 | 16 | [0, 0, -1]
PB.04 | 50.0 | 197.5 | 16.0 | 4.5 | 16 | [0, 0, -1]
PB.05 | 250.0 | 197.5 | 16.0 | 4.5 | 16 | [0, 0, -1]
PB.06 | 450.0 | 197.5 | 16.0 | 4.5 | 16 | [0, 0, -1]

Паз: центр (250; 150), 130x18, R9.0

u вправо, v вверх. n - толщина. Начало в чистовом углу детали; направления в таблице локальные.

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

# PF1 / Опора педалборда 1 / 500 x 35 x 16

HOLD: не передавать в производство до подбора фурнитуры и проверки её присадки. Размеры мм. | 19
PF1.01 | PF1.02 | PF1.03
ID | u | v | n | Ø | глубина | направление
PF1.01 | 50.0 | 17.5 | 16.0 | 2.5 | 12 | [0, 0, -1]
PF1.02 | 250.0 | 17.5 | 16.0 | 2.5 | 12 | [0, 0, -1]
PF1.03 | 450.0 | 17.5 | 16.0 | 2.5 | 12 | [0, 0, -1]

u вправо, v вверх. n - толщина. Начало в чистовом углу детали; направления в таблице локальные.

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

# PF2 / Опора педалборда 2 / 500 x 35 x 16

HOLD: не передавать в производство до подбора фурнитуры и проверки её присадки. Размеры мм. | 20
PF2.01 | PF2.02 | PF2.03
ID | u | v | n | Ø | глубина | направление
PF2.01 | 50.0 | 17.5 | 16.0 | 2.5 | 12 | [0, 0, -1]
PF2.02 | 250.0 | 17.5 | 16.0 | 2.5 | 12 | [0, 0, -1]
PF2.03 | 450.0 | 17.5 | 16.0 | 2.5 | 12 | [0, 0, -1]

u вправо, v вверх. n - толщина. Начало в чистовом углу детали; направления в таблице локальные.

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
