boxforkonstantin-max/guitar-stand/ldsp-onstage/output-d2/pdf/workstation_D2.pdf

### WORKSTATION / D2 / 12.10.2026

# Что изменилось и условия выпуска

D2 - проект для контрольного образца. Не серийный допуск. Размеры мм; сверить контрольные условия. | 1

Корпус 654 x 360 x 800; с боковой опорой гитары общая ширина 834. Высота без мягких подпятников.

Плашки A больше нет. Гитара стоит на нижних мягких опорах, гриф удерживают вилка GN и ремешок.

Ящик на BOYARD DB4501Zn/300: боковой зазор 12,7 мм, полный ход 300 мм, съёмный педалборд внутри.

Нажатие ногой допускается только на вынутой площадке, стоящей на полу. На выдвинутый ящик не наступать.

Полка K опирается на два ребра KF/KR высотой 80 мм. ВСЕ детали - ЛДСП 16 мм, один лист.

K: верх 236; верх Katana 634; до столешницы 150. AIRSTEP хранится на высоте 90.

Чистовые размеры после кромки 0,4 мм. Распил прямоугольников: обе оси минус 0,8 мм.

GN: паз открыт наружу, R33, центр дуги (85;80); оклеить/закрыть торец, мягкая накладка 3 мм.

Все материалы должны отвечать принятым минимальным E/прочности; это проверяет паспорт выбранной плиты.

КОНТРОЛЬНЫЕ УСЛОВИЯ: актуальная присадка направляющих, крепление к стене, образец гитары, нагрузочная проба.

Устойчивость при толчке 50 Н не обеспечена во всех состояниях: требуется противоопрокидывающая связь.

Вентиляция по поручению владельца отложена. Этот выпуск не разрешает эксплуатацию усилителя в нише.

Чертежи и 3D получены из d2_geometry.py; R6 не изменён. Конструкция не является точной копией On-Stage.

# Ящик: монтаж и последовательность открывания

D2 - проект для контрольного образца. Не серийный допуск. Размеры мм; сверить контрольные условия. | 2
1. Направляющие установить вертикально на боковины; не класть плашмя под дно.
2. Проём корпуса 622. Наружная ширина ящика 596,6 = 622 - 2 x 12,7; контролировать после кромления.
3. Перед направляющей Z32, линия крепежа Y92. Боковины ящика 300 x 90 x 16.
4. Корпусные пилоты: Z64 и 203,5. На ящике: Z104, 232, 296. Ø2,5 глубина 12 с пласти.
5. Координаты по копии схемы DB4501 редакции 2014. Другие каталоги имеют отличия до 1 мм.

До серийного сверления наложить купленную направляющую на шаблон 1:1; не сверлить по названию товара.

6. Крепёж: шуруп с полукруглой головкой 3,5x16; головка не должна задевать подвижный профиль.
7. Потянуть за прорезь фасада: весь ящик перемещается на 300 мм. Направляющие имеют штатный упор.
8. Взять педалборд PB за боковые края, приподнять выше бортов ящика и поставить на пол.
9. Кабель USB: свободная петля не менее 700 мм, не попадает в шарики и под ножки.
10. Для снятия самого ящика использовать рычаги расцепления направляющих; петли и доводчик не нужны.
11. Обратный порядок: поставить педалборд на дно QB, уложить кабель, задвинуть ящик без усилия.

Не считать паспортные 15 кг направляющих разрешением нажимать на них ногой.

# Гитара: опоры и удержание грифа

D2 - проект для контрольного образца. Не серийный допуск. Размеры мм; сверить контрольные условия. | 3

GB опирается на общие планки E1/E2. Вес гитары передаётся на пол, а не на верхнюю вилку.

G1/G2 поддерживают низ корпуса; между ними 50 мм для нижнего ременного пина.

Предельная расчётная масса гитары 5 кг. Предварительный габарит корпуса: до 340 по Z, 60 по X.

Гриф в зоне GN должен проходить в 60-мм мягкий проём без давления на струны и лады.

GN поддерживают два ребра GC1/GC2. Каждое прикреплено двумя конфирматами к боковине R.

Вилка крепится к рёбрам четырьмя конфирматами. Пазы 22x5 служат для ремешка шириной 16 мм.

Ремешок пропустить через пазы, замкнуть перед грифом; он препятствует выпадению, а не держит вес.

Мягкие накладки 3 мм закрывают опоры и кромки вилки. Клей и грубая сторона липучки не касаются гитары.

Декоративная модель Ibanez условная: общая форма/геометрия конкретного инструмента не измерена.

Контрольная примерка обязательна: пин не нагружен, корпус стоит устойчиво, покрытие совместимо с накладкой.

Расчёт вилки: 30 Н на плече 160 = 4800 Н·мм; при базе крепежа 44 мм верхний винт воспринимает около 55 Н.

Прочность вырыва конфирматов из фактической ЛДСП не известна: выполнить пробу вилки 60 Н без инструмента.

Сначала испытывать эквивалентом груза, не инструментом. Не подвешивать инструмент за GN.

# Расчёт: полка и педалборд

D2 - проект для контрольного образца. Не серийный допуск. Размеры мм; сверить контрольные условия. | 4

Модель усиления: ОДНО ребро L622, b16, h80 несёт все 20 кг в центре; второе не учитываем.

E = 1600 Н/мм², предел изгиба 11 МПа, коэффициент 3. Требовать паспорт фактической плиты.

I = b h³ / 12; M = P L / 4; sigma = M / (b h² / 6); f = P L³ / (48 E I).

Напряжение 1.788 МПа < 3.667 МПа; мгновенный прогиб 0.901 мм.

Условный множитель ползучести 3: 2.702 мм < L/200 = 3.11 мм.

Плита K между рёбрами: пролёт 328, ширина распределения 470; 20 кг. Составная работа не учитывается.

Для локальных точечных нагрузок на плиту нужен отдельный расчёт; здесь принят габарит Katana.

Педалборд на полу: нагрузка 300 Н по полосе 70 мм, пролёт 140 мм: sigma 3.516 МПа, f 0.449 мм.

300 Н - выбранное проектное усилие нажатия; это не разрешение вставать всем весом.

Ящик с площадкой и AIRSTEP: древесина + педаль 4.73 кг, паспорт пары 15 кг.

Фурнитура и дополнительное содержимое: суммарная масса подвижного узла не более 10 кг.

Соединения ЛДСП и накладки требуют контрольной сборки: расчёт балки не проверяет вырыв/смятие/расшатывание.

# Устойчивость: десять состояний

D2 - проект для контрольного образца. Не серийный допуск. Размеры мм; сверить контрольные условия. | 5
Katana / ящик открыт / гитара | Масса Xcg / Zcg | Mвперёд Fкр на высоте 800
нет / нет / нет | 22.23 кг | 353.7 / 182.4 | 35.41 Нм | 44.3 Н
нет / нет / да | 27.23 кг | 425.4 / 181.9 | 43.26 Нм | 54.1 Н
нет / да / нет | 22.23 кг | 353.7 / 118.5 | 21.48 Нм | 26.8 Н
нет / да / да | 27.23 кг | 425.4 / 129.8 | 29.33 Нм | 36.7 Н
да / нет / нет | 33.83 кг | 344.6 / 176.1 | 51.80 Нм | 64.7 Н
да / нет / да | 38.83 кг | 396.0 / 176.6 | 59.65 Нм | 74.6 Н
да / да / нет | 33.83 кг | 344.6 / 134.1 | 37.87 Нм | 47.3 Н
да / да / да | 38.83 кг | 396.0 / 140.0 | 45.71 Нм | 57.1 Н
Пустой / закрыт | 20.07 кг | 356.6 / 185.1 | 32.51 Нм | 40.6 Н
Пустой / открыт | 20.07 кг | 356.6 / 124.1 | 20.49 Нм | 25.6 Н

Опорный прямоугольник: X0..834, Z20..340. Плотность 600 кг/м³; масса фурнитуры не учтена.

М = Σ m g (Zcg - 20) / 1000; Fкр = М / 0,8. Скольжение и динамика не включены.

Открывание за низкую ручку безопаснее толчка столешницы: сравнить момент 30 Н x 0,092 м.

Случай без Katana не проходит 50 Н сверху. Без крепления к стене производственный допуск НЕ выдаётся.

Первые 8 случаев включают ноутбук и AIRSTEP; последние 2 - полностью без техники.

Сверления не вычтены из массы; центры фигур приближены. Для допуска нужна контрольная проба.

# Стеновое крепление / только бетон C20/25

D2 - проект для контрольного образца. Не серийный допуск. Размеры мм; сверить контрольные условия. | 6

Два fischer SXRL 10x160 FUS (522724), две шайбы DIN9021 M10, шесть прокладок W 50x50x16.

Координаты отверстий в U: мировой X100 и X554, Y720, вход Z344; Ø11 сквозное.

За каждым отверстием собрать три прокладки: 48 мм между задней гранью корпуса Z360 и стеной Z408.

Древесина 16+48=64; шайба 2,5; фактическое заглубление дюбеля около 93,5 мм.

Бур Ø10. Минимум 170 мм от плоскости опоры головки (около 104 мм в бетоне). Удалить пыль.

Перед сверлением проверить отсутствие проводки/труб. Не считать штукатурку несущим бетоном.

Если слой штукатурки уменьшает заделку ниже 90 мм, этот узел неприменим без пересчёта.

Принять стену толщиной не менее 150 мм, до края бетона не менее 140 мм; межосевое расстояние 454 мм.

Расчётное требование: 200 Н на высоте 800 дают 160 Нм; связь на Y720 воспринимает 222,2 Н суммарно.

Учитывать неравномерность: каждый анкер и его соединение с U должны переносить не менее 223 Н.

Это требование к соединению, а не подтверждённая несущая способность неизвестной стены.

Приёмка: безопасная проба 300 Н на связь, без деформации/вырыва. Стойку не использовать без крепления.

Гипсокартон, газоблок, пустотелый кирпич: монтаж по этому листу запрещён; нужен иной анкерный узел.

Источники: fischer SXRL, ETA-07/0121, таблица допускаемых нагрузок; EGGER P2, паспорт 08.04.2026. (https://www.fischerfixing.ru/wp-content/uploads/2026/02/buklet-sxrl.pdf)

Каталог SXRL: 2,58 кН растяжения в бетоне при h70 для групповых креплений; не допуск всей стойки. (https://www.egger.com/get_download/6603a8d4-4c68-446d-b77a-193672c87f5a/Technical_Datasheet_Eurospan_E1_P2.pdf)

# Габариты сборки / проекции (справочные, размеры по деталям)

D2 - проект для контрольного образца. Не серийный допуск. Размеры мм; сверить контрольные условия. | 7

## Спереди

Корпус H800; полка Katana Y236; столешница Y800.

## Справа

Корпус H800; полка Katana Y236; столешница Y800.

Ширина корпуса 654; основание с гитарой 834; глубина 360; стена Z408; ручка на фасаде.

# Раскрой ЛДСП 16 мм / 1 лист 2500 x 1830

D2 - проект для контрольного образца. Не серийный допуск. Размеры мм; сверить контрольные условия. | 8

QB
PB

GB

GN

GC1 | GC2 | F
QL | QR
D | K
L | R | T

U

W100_1 W100_2

W100_3 W554_1 W554_2

W554_3 | G1 | G2
E1 | E2
KF | KR | V
PF1

PF2

Пропил 4 мм; обрезка 10 мм.

Белый декор без направления.

Координаты: nesting.json.

Все 30 деталей - 16 мм.

Рёбра KF/KR входят в лист.

Малые детали W вырезать из укрупнённой заготовки с безопасной фиксацией; не держать руками у пилы.

# Деталировка и кромка

D2 - проект для контрольного образца. Не серийный допуск. Размеры мм; сверить контрольные условия. | 9
ID | Деталь | Чистовой размер | Распил | Толщина
L | Боковина левая | 360 x 768 | 359.2 x 767.2 | 16
R | Боковина правая | 360 x 768 | 359.2 x 767.2 | 16
T | Столешница ноутбука | 654 x 360 | 653.2 x 359.2 | 16
D | Дно корпуса | 622 x 360 | 621.2 x 359.2 | 16
K | Полка Katana | 622 x 360 | 621.2 x 359.2 | 16
KF | Переднее ребро полки | 622 x 80 | 621.2 x 79.2 | 16
KR | Заднее ребро полки | 622 x 80 | 621.2 x 79.2 | 16
V | Нижняя задняя связь | 622 x 80 | 621.2 x 79.2 | 16
U | Верхняя задняя связь | 622 x 80 | 621.2 x 79.2 | 16
W100_1 | Дистанционная прокладка стены | 50 x 50 | 49.2 x 49.2 | 16
W100_2 | Дистанционная прокладка стены | 50 x 50 | 49.2 x 49.2 | 16
W100_3 | Дистанционная прокладка стены | 50 x 50 | 49.2 x 49.2 | 16
W554_1 | Дистанционная прокладка стены | 50 x 50 | 49.2 x 49.2 | 16
W554_2 | Дистанционная прокладка стены | 50 x 50 | 49.2 x 49.2 | 16
W554_3 | Дистанционная прокладка стены | 50 x 50 | 49.2 x 49.2 | 16
E1 | Передняя общая опора | 834 x 50 | 833.2 x 49.2 | 16
E2 | Задняя общая опора | 834 x 50 | 833.2 x 49.2 | 16
GB | Основание гитары | 180 x 360 | 179.2 x 359.2 | 16
G1 | Мягкая опора корпуса 1 | 160 x 50 | 159.2 x 49.2 | 16
G2 | Мягкая опора корпуса 2 | 160 x 50 | 159.2 x 49.2 | 16
GN | Вилка грифа | 160 x 160 | 159.2 x 159.2 | 16

# Деталировка и кромка

D2 - проект для контрольного образца. Не серийный допуск. Размеры мм; сверить контрольные условия. | 10
ID | Деталь | Чистовой размер | Распил | Толщина
GC1 | Ребро вилки переднее | 160 x 100 | 159.2 x 99.2 | 16
GC2 | Ребро вилки заднее | 160 x 100 | 159.2 x 99.2 | 16
QL | Бок ящика левый | 300 x 90 | 299.2 x 89.2 | 16
QR | Бок ящика правый | 300 x 90 | 299.2 x 89.2 | 16
QB | Дно ящика | 564.6 x 300 | 563.8 x 299.2 | 16
F | Фасад ящика | 618 x 100 | 617.2 x 99.2 | 16
PB | Съёмная площадка AIRSTEP | 500 x 220 | 499.2 x 219.2 | 16
PF1 | Опора педалборда 1 | 500 x 35 | 499.2 x 34.2 | 16
PF2 | Опора педалборда 2 | 500 x 35 | 499.2 x 34.2 | 16

# L / Боковина левая / 360 x 768 x 16

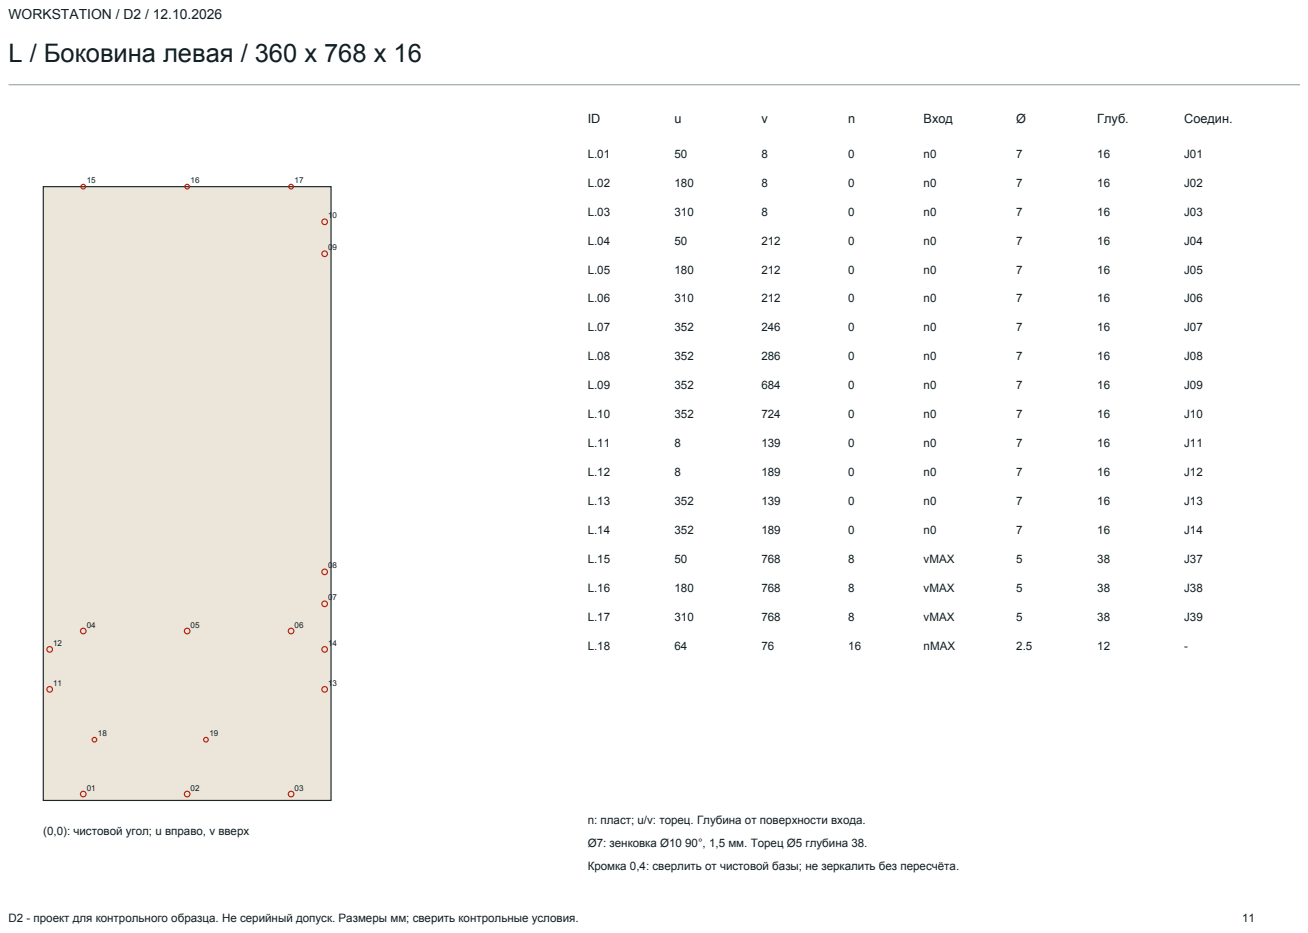
[picture p17: page 11]

n: пласт; u/v: торец. Глубина от поверхности входа.

(0,0): чистовой угол; u вправо, v вверх

Ø7: зенковка Ø10 90°, 1,5 мм. Торец Ø5 глубина 38.

Кромка 0,4: сверлить от чистовой базы; не зеркалить без пересчёта.

# L / Боковина левая / 360 x 768 x 16

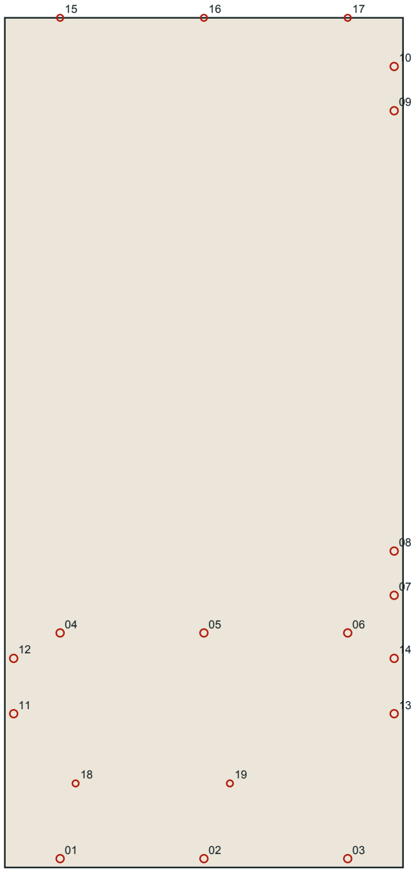
[picture p18: figure]

D2 - проект для контрольного образца. Не серийный допуск. Размеры мм; сверить контрольные условия. | 12

(0,0): чистовой угол; u вправо, v вверх

ID | u | v | n | Вход | Ø | Глуб. | Соедин.
L.19 | 203.5 | 76.0 | 16.0 | nMAX | 2.5 | 12 | -

n: пласт; u/v: торец. Глубина от поверхности входа.

Ø7: зенковка Ø10 90°, 1,5 мм. Торец Ø5 глубина 38.

Кромка 0,4: сверлить от чистовой базы; не зеркалить без пересчёта.

# R / Боковина правая / 360 x 768 x 16

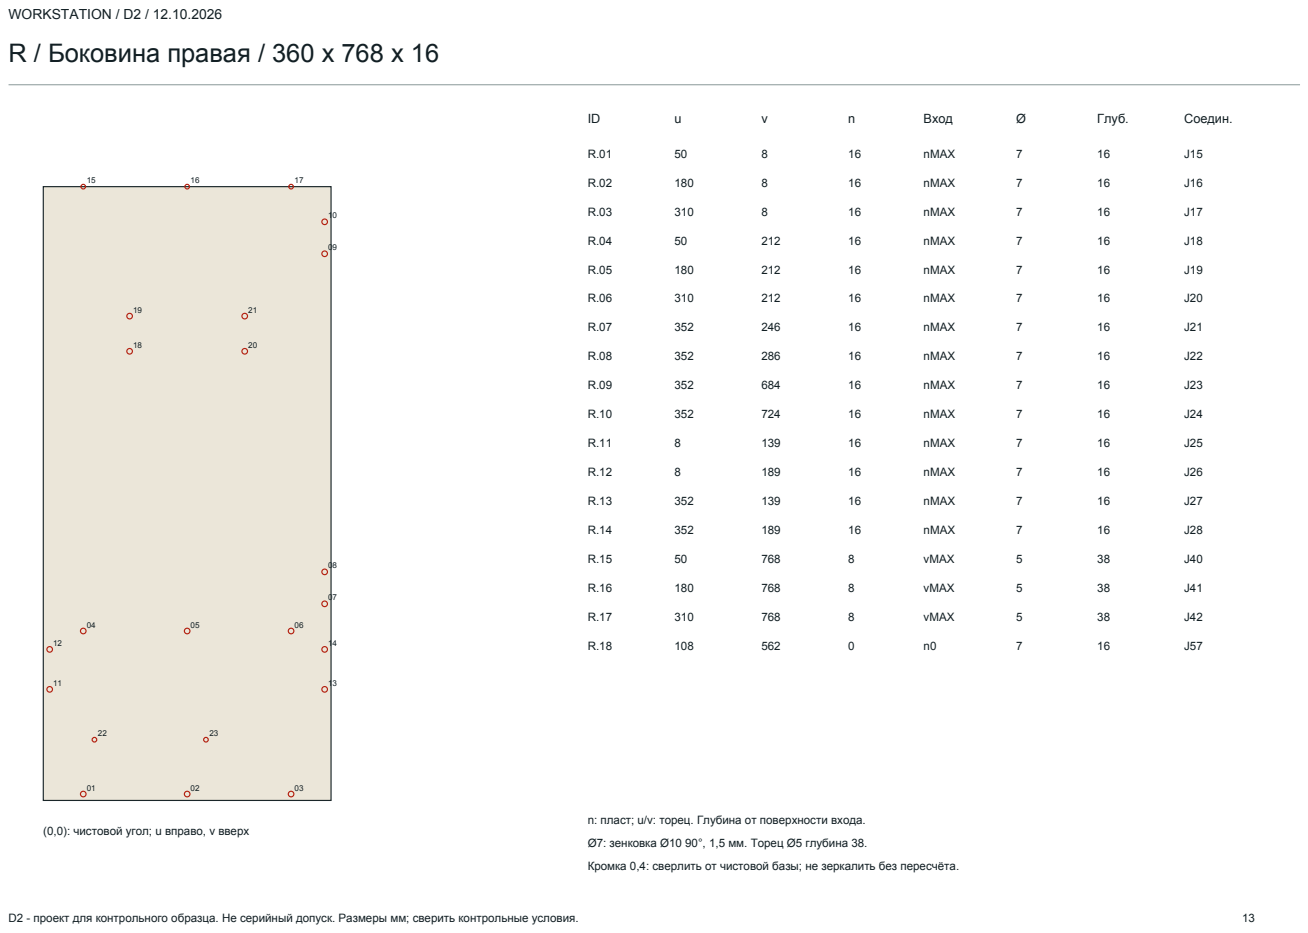
[picture p19: page 13]

n: пласт; u/v: торец. Глубина от поверхности входа.

(0,0): чистовой угол; u вправо, v вверх

Ø7: зенковка Ø10 90°, 1,5 мм. Торец Ø5 глубина 38.

Кромка 0,4: сверлить от чистовой базы; не зеркалить без пересчёта.

# R / Боковина правая / 360 x 768 x 16

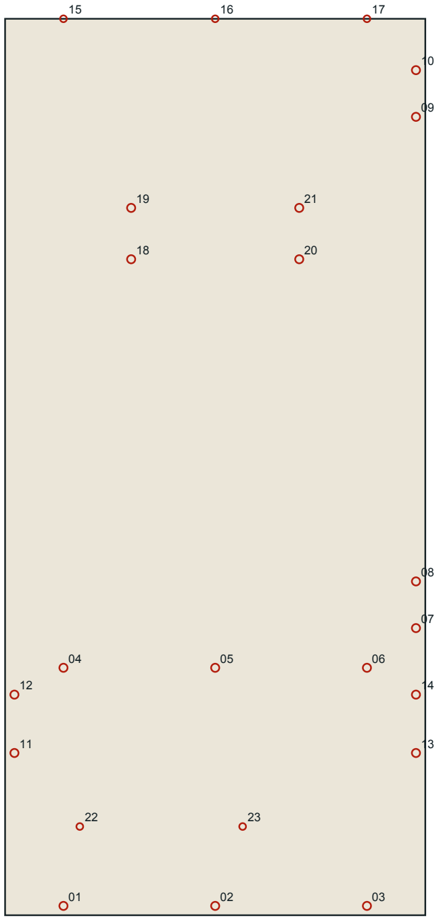
[picture p20: figure]

D2 - проект для контрольного образца. Не серийный допуск. Размеры мм; сверить контрольные условия. | 14

(0,0): чистовой угол; u вправо, v вверх

ID | u | v | n | Вход | Ø | Глуб. | Соедин.
R.19 | 108 | 606 | 0 | n0 | 7 | 16 | J58
R.20 | 252 | 562 | 0 | n0 | 7 | 16 | J61
R.21 | 252 | 606 | 0 | n0 | 7 | 16 | J62
R.22 | 64 | 76 | 0 | n0 | 2.5 | 12 | -
R.23 | 203.5 | 76.0 | 0.0 | n0 | 2.5 | 12 | -

n: пласт; u/v: торец. Глубина от поверхности входа.

Ø7: зенковка Ø10 90°, 1,5 мм. Торец Ø5 глубина 38.

Кромка 0,4: сверлить от чистовой базы; не зеркалить без пересчёта.

# T / Столешница ноутбука / 654 x 360 x 16

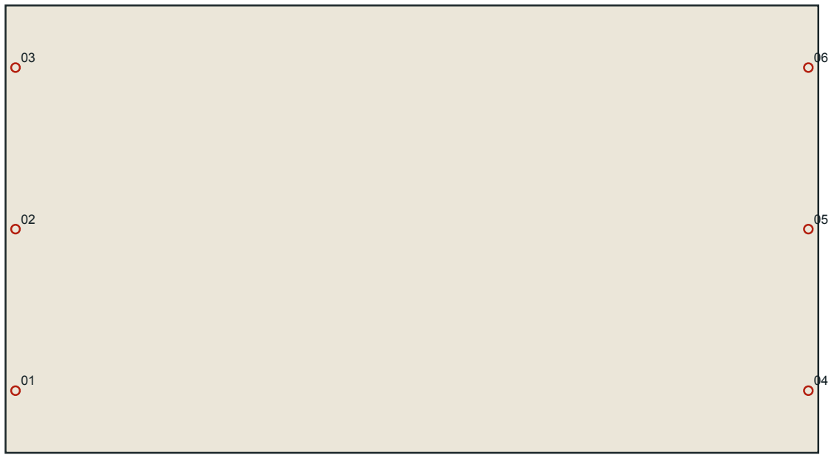
[picture p21: figure]

D2 - проект для контрольного образца. Не серийный допуск. Размеры мм; сверить контрольные условия. | 15

(0,0): чистовой угол; u вправо, v вверх

ID | u | v | n | Вход | Ø | Глуб. | Соедин.
T.01 | 8 | 50 | 16 | nMAX | 7 | 16 | J37
T.02 | 8 | 180 | 16 | nMAX | 7 | 16 | J38
T.03 | 8 | 310 | 16 | nMAX | 7 | 16 | J39
T.04 | 646 | 50 | 16 | nMAX | 7 | 16 | J40
T.05 | 646 | 180 | 16 | nMAX | 7 | 16 | J41
T.06 | 646 | 310 | 16 | nMAX | 7 | 16 | J42

n: пласт; u/v: торец. Глубина от поверхности входа.

Ø7: зенковка Ø10 90°, 1,5 мм. Торец Ø5 глубина 38.

Кромка 0,4: сверлить от чистовой базы; не зеркалить без пересчёта.

# D / Дно корпуса / 622 x 360 x 16

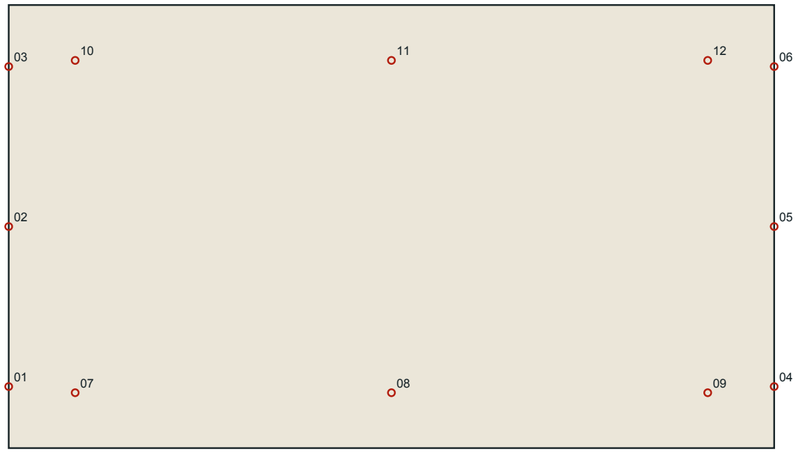
[picture p22: figure]

D2 - проект для контрольного образца. Не серийный допуск. Размеры мм; сверить контрольные условия. | 16

(0,0): чистовой угол; u вправо, v вверх

ID | u | v | n | Вход | Ø | Глуб. | Соедин.
D.01 | 0 | 50 | 8 | u0 | 5 | 38 | J01
D.02 | 0 | 180 | 8 | u0 | 5 | 38 | J02
D.03 | 0 | 310 | 8 | u0 | 5 | 38 | J03
D.04 | 622 | 50 | 8 | uMAX | 5 | 38 | J15
D.05 | 622 | 180 | 8 | uMAX | 5 | 38 | J16
D.06 | 622 | 310 | 8 | uMAX | 5 | 38 | J17
D.07 | 54 | 45 | 16 | nMAX | 4.5 | 16 | J43
D.08 | 311 | 45 | 16 | nMAX | 4.5 | 16 | J44
D.09 | 568 | 45 | 16 | nMAX | 4.5 | 16 | J45
D.10 | 54 | 315 | 16 | nMAX | 4.5 | 16 | J48
D.11 | 311 | 315 | 16 | nMAX | 4.5 | 16 | J49
D.12 | 568 | 315 | 16 | nMAX | 4.5 | 16 | J50

n: пласт; u/v: торец. Глубина от поверхности входа.

Ø7: зенковка Ø10 90°, 1,5 мм. Торец Ø5 глубина 38.

Кромка 0,4: сверлить от чистовой базы; не зеркалить без пересчёта.

# K / Полка Katana / 622 x 360 x 16

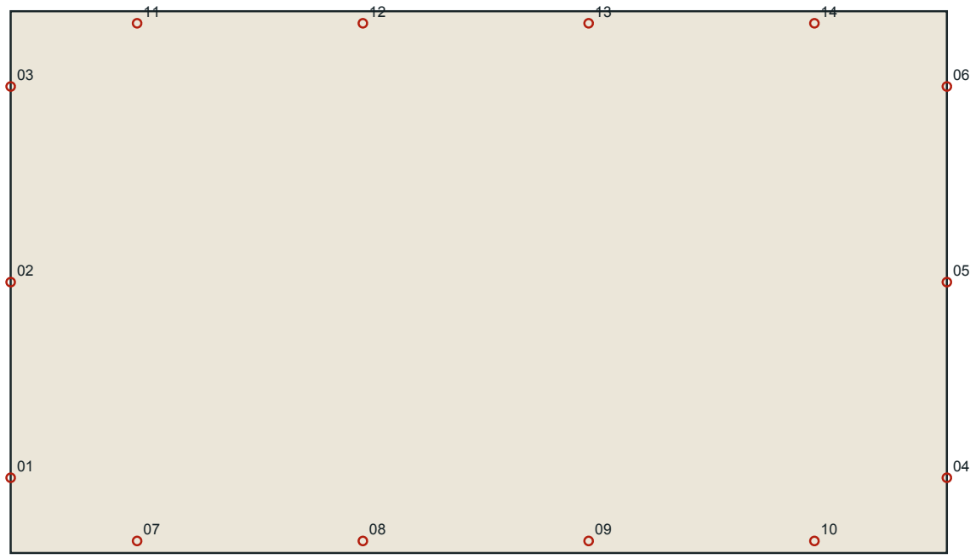
[picture p23: figure]

D2 - проект для контрольного образца. Не серийный допуск. Размеры мм; сверить контрольные условия. | 17

(0,0): чистовой угол; u вправо, v вверх

ID | u | v | n | Вход | Ø | Глуб. | Соедин.
K.01 | 0 | 50 | 8 | u0 | 5 | 38 | J04
K.02 | 0 | 180 | 8 | u0 | 5 | 38 | J05
K.03 | 0 | 310 | 8 | u0 | 5 | 38 | J06
K.04 | 622 | 50 | 8 | uMAX | 5 | 38 | J18
K.05 | 622 | 180 | 8 | uMAX | 5 | 38 | J19
K.06 | 622 | 310 | 8 | uMAX | 5 | 38 | J20
K.07 | 84 | 8 | 16 | nMAX | 4.5 | 16 | J29
K.08 | 234 | 8 | 16 | nMAX | 4.5 | 16 | J30
K.09 | 384 | 8 | 16 | nMAX | 4.5 | 16 | J31
K.10 | 534 | 8 | 16 | nMAX | 4.5 | 16 | J32
K.11 | 84 | 352 | 16 | nMAX | 4.5 | 16 | J33
K.12 | 234 | 352 | 16 | nMAX | 4.5 | 16 | J34
K.13 | 384 | 352 | 16 | nMAX | 4.5 | 16 | J35
K.14 | 534 | 352 | 16 | nMAX | 4.5 | 16 | J36

n: пласт; u/v: торец. Глубина от поверхности входа.

Ø7: зенковка Ø10 90°, 1,5 мм. Торец Ø5 глубина 38.

Кромка 0,4: сверлить от чистовой базы; не зеркалить без пересчёта.

# KF / Переднее ребро полки / 622 x 80 x 16

D2 - проект для контрольного образца. Не серийный допуск. Размеры мм; сверить контрольные условия. | 18

(0,0): чистовой угол; u вправо, v вверх

01

02

03

04

05 | 06 | 07 | 08
ID | u | v | n | Вход | Ø | Глуб. | Соедин.
KF.01 | 0 | 15 | 8 | u0 | 5 | 38 | J11
KF.02 | 0 | 65 | 8 | u0 | 5 | 38 | J12
KF.03 | 622 | 15 | 8 | uMAX | 5 | 38 | J25
KF.04 | 622 | 65 | 8 | uMAX | 5 | 38 | J26
KF.05 | 84 | 80 | 8 | vMAX | 2.5 | 12 | J29
KF.06 | 234 | 80 | 8 | vMAX | 2.5 | 12 | J30
KF.07 | 384 | 80 | 8 | vMAX | 2.5 | 12 | J31
KF.08 | 534 | 80 | 8 | vMAX | 2.5 | 12 | J32

n: пласт; u/v: торец. Глубина от поверхности входа.

Ø7: зенковка Ø10 90°, 1,5 мм. Торец Ø5 глубина 38.

Кромка 0,4: сверлить от чистовой базы; не зеркалить без пересчёта.

# KR / Заднее ребро полки / 622 x 80 x 16

D2 - проект для контрольного образца. Не серийный допуск. Размеры мм; сверить контрольные условия. | 19

(0,0): чистовой угол; u вправо, v вверх

01

02

03

04

05 | 06 | 07 | 08
ID | u | v | n | Вход | Ø | Глуб. | Соедин.
KR.01 | 0 | 15 | 8 | u0 | 5 | 38 | J13
KR.02 | 0 | 65 | 8 | u0 | 5 | 38 | J14
KR.03 | 622 | 15 | 8 | uMAX | 5 | 38 | J27
KR.04 | 622 | 65 | 8 | uMAX | 5 | 38 | J28
KR.05 | 84 | 80 | 8 | vMAX | 2.5 | 12 | J33
KR.06 | 234 | 80 | 8 | vMAX | 2.5 | 12 | J34
KR.07 | 384 | 80 | 8 | vMAX | 2.5 | 12 | J35
KR.08 | 534 | 80 | 8 | vMAX | 2.5 | 12 | J36

n: пласт; u/v: торец. Глубина от поверхности входа.

Ø7: зенковка Ø10 90°, 1,5 мм. Торец Ø5 глубина 38.

Кромка 0,4: сверлить от чистовой базы; не зеркалить без пересчёта.

# V / Нижняя задняя связь / 622 x 80 x 16

D2 - проект для контрольного образца. Не серийный допуск. Размеры мм; сверить контрольные условия. | 20

(0,0): чистовой угол; u вправо, v вверх

01

02

03

04

ID | u | v | n | Вход | Ø | Глуб. | Соедин.
V.01 | 0 | 20 | 8 | u0 | 5 | 38 | J07
V.02 | 0 | 60 | 8 | u0 | 5 | 38 | J08
V.03 | 622 | 20 | 8 | uMAX | 5 | 38 | J21
V.04 | 622 | 60 | 8 | uMAX | 5 | 38 | J22

n: пласт; u/v: торец. Глубина от поверхности входа.

Ø7: зенковка Ø10 90°, 1,5 мм. Торец Ø5 глубина 38.

Кромка 0,4: сверлить от чистовой базы; не зеркалить без пересчёта.

# U / Верхняя задняя связь / 622 x 80 x 16

D2 - проект для контрольного образца. Не серийный допуск. Размеры мм; сверить контрольные условия. | 21

(0,0): чистовой угол; u вправо, v вверх

01 | 02

03

04

05

06

ID | u | v | n | Вход | Ø | Глуб. | Соедин.
U.01 | 84 | 40 | 0 | n0 | 11 | 16 | -
U.02 | 538 | 40 | 0 | n0 | 11 | 16 | -
U.03 | 0 | 20 | 8 | u0 | 5 | 38 | J09
U.04 | 0 | 60 | 8 | u0 | 5 | 38 | J10
U.05 | 622 | 20 | 8 | uMAX | 5 | 38 | J23
U.06 | 622 | 60 | 8 | uMAX | 5 | 38 | J24

n: пласт; u/v: торец. Глубина от поверхности входа.

Ø7: зенковка Ø10 90°, 1,5 мм. Торец Ø5 глубина 38.

Кромка 0,4: сверлить от чистовой базы; не зеркалить без пересчёта.

# W100_1 / Дистанционная прокладка стены / 50 x 50 x 16

D2 - проект для контрольного образца. Не серийный допуск. Размеры мм; сверить контрольные условия. | 22

(0,0): чистовой угол; u вправо, v вверх

01

ID | u | v | n | Вход | Ø | Глуб. | Соедин.
W100_1.01 | 25 | 25 | 0 | n0 | 11 | 16 | -

n: пласт; u/v: торец. Глубина от поверхности входа.

Ø7: зенковка Ø10 90°, 1,5 мм. Торец Ø5 глубина 38.

Кромка 0,4: сверлить от чистовой базы; не зеркалить без пересчёта.

# W100_2 / Дистанционная прокладка стены / 50 x 50 x 16

D2 - проект для контрольного образца. Не серийный допуск. Размеры мм; сверить контрольные условия. | 23

(0,0): чистовой угол; u вправо, v вверх

01

ID | u | v | n | Вход | Ø | Глуб. | Соедин.
W100_2.01 | 25 | 25 | 0 | n0 | 11 | 16 | -

n: пласт; u/v: торец. Глубина от поверхности входа.

Ø7: зенковка Ø10 90°, 1,5 мм. Торец Ø5 глубина 38.

Кромка 0,4: сверлить от чистовой базы; не зеркалить без пересчёта.

# W100_3 / Дистанционная прокладка стены / 50 x 50 x 16

D2 - проект для контрольного образца. Не серийный допуск. Размеры мм; сверить контрольные условия. | 24

(0,0): чистовой угол; u вправо, v вверх

01

ID | u | v | n | Вход | Ø | Глуб. | Соедин.
W100_3.01 | 25 | 25 | 0 | n0 | 11 | 16 | -

n: пласт; u/v: торец. Глубина от поверхности входа.

Ø7: зенковка Ø10 90°, 1,5 мм. Торец Ø5 глубина 38.

Кромка 0,4: сверлить от чистовой базы; не зеркалить без пересчёта.

# W554_1 / Дистанционная прокладка стены / 50 x 50 x 16

D2 - проект для контрольного образца. Не серийный допуск. Размеры мм; сверить контрольные условия. | 25

(0,0): чистовой угол; u вправо, v вверх

01

ID | u | v | n | Вход | Ø | Глуб. | Соедин.
W554_1.01 | 25 | 25 | 0 | n0 | 11 | 16 | -

n: пласт; u/v: торец. Глубина от поверхности входа.

Ø7: зенковка Ø10 90°, 1,5 мм. Торец Ø5 глубина 38.

Кромка 0,4: сверлить от чистовой базы; не зеркалить без пересчёта.

# W554_2 / Дистанционная прокладка стены / 50 x 50 x 16

D2 - проект для контрольного образца. Не серийный допуск. Размеры мм; сверить контрольные условия. | 26

(0,0): чистовой угол; u вправо, v вверх

01

ID | u | v | n | Вход | Ø | Глуб. | Соедин.
W554_2.01 | 25 | 25 | 0 | n0 | 11 | 16 | -

n: пласт; u/v: торец. Глубина от поверхности входа.

Ø7: зенковка Ø10 90°, 1,5 мм. Торец Ø5 глубина 38.

Кромка 0,4: сверлить от чистовой базы; не зеркалить без пересчёта.

# W554_3 / Дистанционная прокладка стены / 50 x 50 x 16

D2 - проект для контрольного образца. Не серийный допуск. Размеры мм; сверить контрольные условия. | 27

(0,0): чистовой угол; u вправо, v вверх

01

ID | u | v | n | Вход | Ø | Глуб. | Соедин.
W554_3.01 | 25 | 25 | 0 | n0 | 11 | 16 | -

n: пласт; u/v: торец. Глубина от поверхности входа.

Ø7: зенковка Ø10 90°, 1,5 мм. Торец Ø5 глубина 38.

Кромка 0,4: сверлить от чистовой базы; не зеркалить без пересчёта.

# E1 / Передняя общая опора / 834 x 50 x 16

D2 - проект для контрольного образца. Не серийный допуск. Размеры мм; сверить контрольные условия. | 28

(0,0): чистовой угол; u вправо, v вверх

01 | 02 | 03 | 04 | 05
ID | u | v | n | Вход | Ø | Глуб. | Соедин.
E1.01 | 70 | 25 | 16 | nMAX | 2.5 | 12 | J43
E1.02 | 327 | 25 | 16 | nMAX | 2.5 | 12 | J44
E1.03 | 584 | 25 | 16 | nMAX | 2.5 | 12 | J45
E1.04 | 700 | 25 | 16 | nMAX | 2.5 | 12 | J46
E1.05 | 790 | 25 | 16 | nMAX | 2.5 | 12 | J47

n: пласт; u/v: торец. Глубина от поверхности входа.

Ø7: зенковка Ø10 90°, 1,5 мм. Торец Ø5 глубина 38.

Кромка 0,4: сверлить от чистовой базы; не зеркалить без пересчёта.

# E2 / Задняя общая опора / 834 x 50 x 16

D2 - проект для контрольного образца. Не серийный допуск. Размеры мм; сверить контрольные условия. | 29

(0,0): чистовой угол; u вправо, v вверх

01 | 02 | 03 | 04 | 05
ID | u | v | n | Вход | Ø | Глуб. | Соедин.
E2.01 | 70 | 25 | 16 | nMAX | 2.5 | 12 | J48
E2.02 | 327 | 25 | 16 | nMAX | 2.5 | 12 | J49
E2.03 | 584 | 25 | 16 | nMAX | 2.5 | 12 | J50
E2.04 | 700 | 25 | 16 | nMAX | 2.5 | 12 | J51
E2.05 | 790 | 25 | 16 | nMAX | 2.5 | 12 | J52

n: пласт; u/v: торец. Глубина от поверхности входа.

Ø7: зенковка Ø10 90°, 1,5 мм. Торец Ø5 глубина 38.

Кромка 0,4: сверлить от чистовой базы; не зеркалить без пересчёта.

# GB / Основание гитары / 180 x 360 x 16

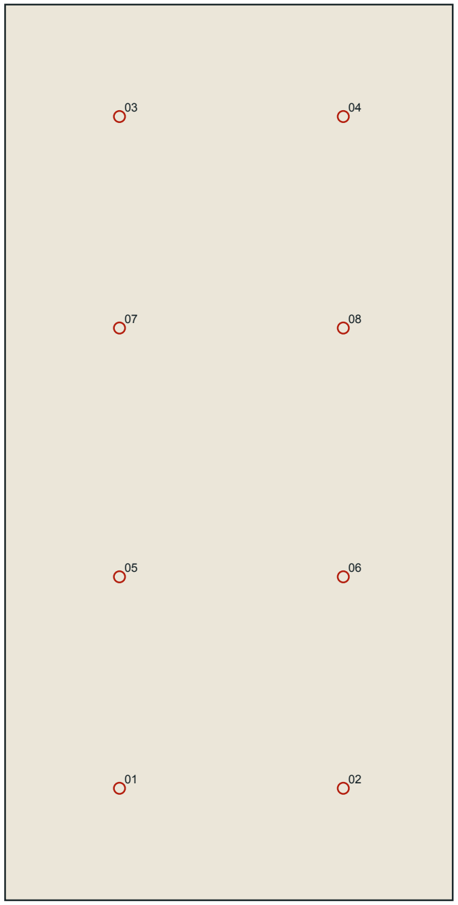
[picture p24: figure]

D2 - проект для контрольного образца. Не серийный допуск. Размеры мм; сверить контрольные условия. | 30

(0,0): чистовой угол; u вправо, v вверх

ID | u | v | n | Вход | Ø | Глуб. | Соедин.
GB.01 | 46 | 45 | 16 | nMAX | 4.5 | 16 | J46
GB.02 | 136 | 45 | 16 | nMAX | 4.5 | 16 | J47
GB.03 | 46 | 315 | 16 | nMAX | 4.5 | 16 | J51
GB.04 | 136 | 315 | 16 | nMAX | 4.5 | 16 | J52
GB.05 | 46 | 130 | 0 | n0 | 4.5 | 16 | J53
GB.06 | 136 | 130 | 0 | n0 | 4.5 | 16 | J54
GB.07 | 46 | 230 | 0 | n0 | 4.5 | 16 | J55
GB.08 | 136 | 230 | 0 | n0 | 4.5 | 16 | J56

n: пласт; u/v: торец. Глубина от поверхности входа.

Ø7: зенковка Ø10 90°, 1,5 мм. Торец Ø5 глубина 38.

Кромка 0,4: сверлить от чистовой базы; не зеркалить без пересчёта.

# G1 / Мягкая опора корпуса 1 / 160 x 50 x 16

D2 - проект для контрольного образца. Не серийный допуск. Размеры мм; сверить контрольные условия. | 31

(0,0): чистовой угол; u вправо, v вверх

01 | 02
ID | u | v | n | Вход | Ø | Глуб. | Соедин.
G1.01 | 36 | 25 | 0 | n0 | 2.5 | 12 | J53
G1.02 | 126 | 25 | 0 | n0 | 2.5 | 12 | J54

n: пласт; u/v: торец. Глубина от поверхности входа.

Ø7: зенковка Ø10 90°, 1,5 мм. Торец Ø5 глубина 38.

Кромка 0,4: сверлить от чистовой базы; не зеркалить без пересчёта.

# G2 / Мягкая опора корпуса 2 / 160 x 50 x 16

D2 - проект для контрольного образца. Не серийный допуск. Размеры мм; сверить контрольные условия. | 32

(0,0): чистовой угол; u вправо, v вверх

01 | 02
ID | u | v | n | Вход | Ø | Глуб. | Соедин.
G2.01 | 36 | 25 | 0 | n0 | 2.5 | 12 | J55
G2.02 | 126 | 25 | 0 | n0 | 2.5 | 12 | J56

n: пласт; u/v: торец. Глубина от поверхности входа.

Ø7: зенковка Ø10 90°, 1,5 мм. Торец Ø5 глубина 38.

Кромка 0,4: сверлить от чистовой базы; не зеркалить без пересчёта.

# GN / Вилка грифа / 160 x 160 x 16

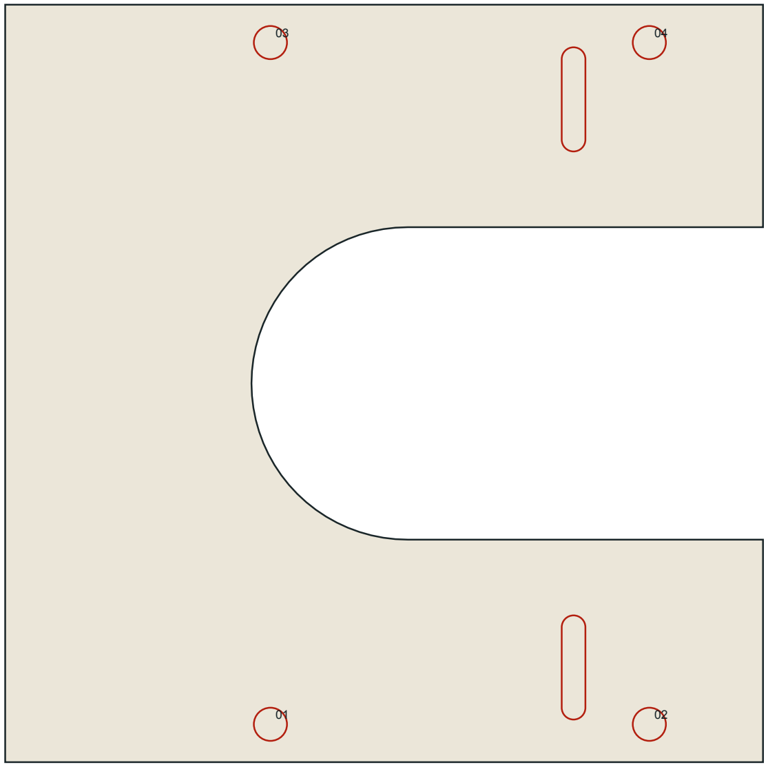
[picture p25: figure]

D2 - проект для контрольного образца. Не серийный допуск. Размеры мм; сверить контрольные условия. | 33

(0,0): чистовой угол; u вправо, v вверх

ID | u | v | n | Вход | Ø | Глуб. | Соедин.
GN.01 | 56 | 8 | 16 | nMAX | 7 | 16 | J59
GN.02 | 136 | 8 | 16 | nMAX | 7 | 16 | J60
GN.03 | 56 | 152 | 16 | nMAX | 7 | 16 | J63
GN.04 | 136 | 152 | 16 | nMAX | 7 | 16 | J64

Паз (120;20), 22x5, ось v, сквозной

Паз (120;140), 22x5, ось v, сквозной

n: пласт; u/v: торец. Глубина от поверхности входа.

Ø7: зенковка Ø10 90°, 1,5 мм. Торец Ø5 глубина 38.

Кромка 0,4: сверлить от чистовой базы; не зеркалить без пересчёта.

# GC1 / Ребро вилки переднее / 160 x 100 x 16

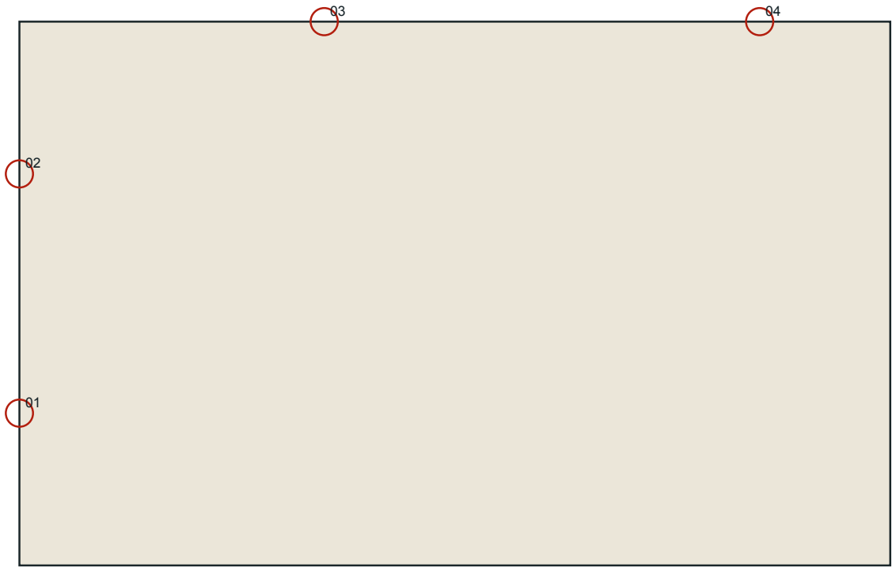
[picture p26: figure]

D2 - проект для контрольного образца. Не серийный допуск. Размеры мм; сверить контрольные условия. | 34

(0,0): чистовой угол; u вправо, v вверх

ID | u | v | n | Вход | Ø | Глуб. | Соедин.
GC1.01 | 0 | 28 | 8 | u0 | 5 | 38 | J57
GC1.02 | 0 | 72 | 8 | u0 | 5 | 38 | J58
GC1.03 | 56 | 100 | 8 | vMAX | 5 | 38 | J59
GC1.04 | 136 | 100 | 8 | vMAX | 5 | 38 | J60

n: пласт; u/v: торец. Глубина от поверхности входа.

Ø7: зенковка Ø10 90°, 1,5 мм. Торец Ø5 глубина 38.

Кромка 0,4: сверлить от чистовой базы; не зеркалить без пересчёта.

# GC2 / Ребро вилки заднее / 160 x 100 x 16

D2 - проект для контрольного образца. Не серийный допуск. Размеры мм; сверить контрольные условия. | 35

(0,0): чистовой угол; u вправо, v вверх

ID | u | v | n | Вход | Ø | Глуб. | Соедин.
GC2.01 | 0 | 28 | 8 | u0 | 5 | 38 | J61
GC2.02 | 0 | 72 | 8 | u0 | 5 | 38 | J62
GC2.03 | 56 | 100 | 8 | vMAX | 5 | 38 | J63
GC2.04 | 136 | 100 | 8 | vMAX | 5 | 38 | J64

n: пласт; u/v: торец. Глубина от поверхности входа.

Ø7: зенковка Ø10 90°, 1,5 мм. Торец Ø5 глубина 38.

Кромка 0,4: сверлить от чистовой базы; не зеркалить без пересчёта.

# QL / Бок ящика левый / 300 x 90 x 16

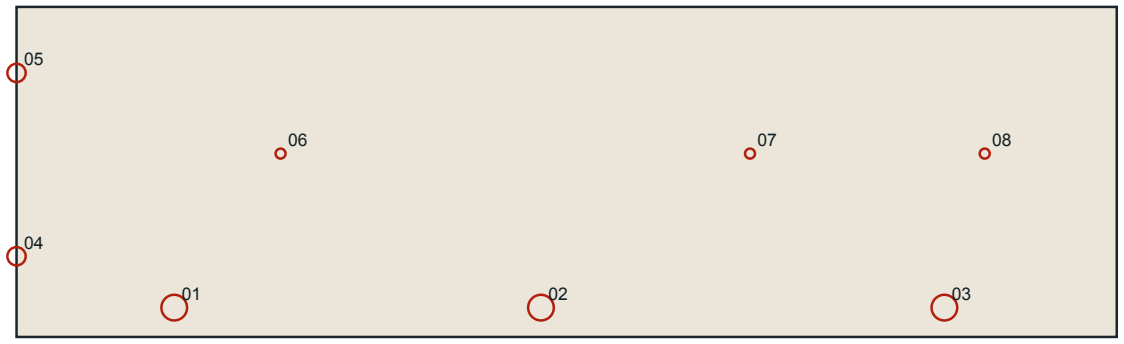
[picture p27: figure]

D2 - проект для контрольного образца. Не серийный допуск. Размеры мм; сверить контрольные условия. | 36

(0,0): чистовой угол; u вправо, v вверх

ID | u | v | n | Вход | Ø | Глуб. | Соедин.
QL.01 | 43.0 | 8.0 | 0.0 | n0 | 7 | 16 | J65
QL.02 | 143.0 | 8.0 | 0.0 | n0 | 7 | 16 | J66
QL.03 | 253.0 | 8.0 | 0.0 | n0 | 7 | 16 | J67
QL.04 | 0.0 | 22.0 | 8.0 | u0 | 5 | 38 | J71
QL.05 | 0.0 | 72.0 | 8.0 | u0 | 5 | 38 | J72
QL.06 | 72.0 | 50.0 | 0.0 | n0 | 2.5 | 12 | -
QL.07 | 200.0 | 50.0 | 0.0 | n0 | 2.5 | 12 | -
QL.08 | 264.0 | 50.0 | 0.0 | n0 | 2.5 | 12 | -

n: пласт; u/v: торец. Глубина от поверхности входа.

Ø7: зенковка Ø10 90°, 1,5 мм. Торец Ø5 глубина 38.

Кромка 0,4: сверлить от чистовой базы; не зеркалить без пересчёта.

# QR / Бок ящика правый / 300 x 90 x 16

D2 - проект для контрольного образца. Не серийный допуск. Размеры мм; сверить контрольные условия. | 37

(0,0): чистовой угол; u вправо, v вверх

ID | u | v | n | Вход | Ø | Глуб. | Соедин.
QR.01 | 43.0 | 8.0 | 16.0 | nMAX | 7 | 16 | J68
QR.02 | 143.0 | 8.0 | 16.0 | nMAX | 7 | 16 | J69
QR.03 | 253.0 | 8.0 | 16.0 | nMAX | 7 | 16 | J70
QR.04 | 0.0 | 22.0 | 8.0 | u0 | 5 | 38 | J73
QR.05 | 0.0 | 72.0 | 8.0 | u0 | 5 | 38 | J74
QR.06 | 72.0 | 50.0 | 16.0 | nMAX | 2.5 | 12 | -
QR.07 | 200.0 | 50.0 | 16.0 | nMAX | 2.5 | 12 | -
QR.08 | 264.0 | 50.0 | 16.0 | nMAX | 2.5 | 12 | -

n: пласт; u/v: торец. Глубина от поверхности входа.

Ø7: зенковка Ø10 90°, 1,5 мм. Торец Ø5 глубина 38.

Кромка 0,4: сверлить от чистовой базы; не зеркалить без пересчёта.

# QB / Дно ящика / 564.6 x 300 x 16

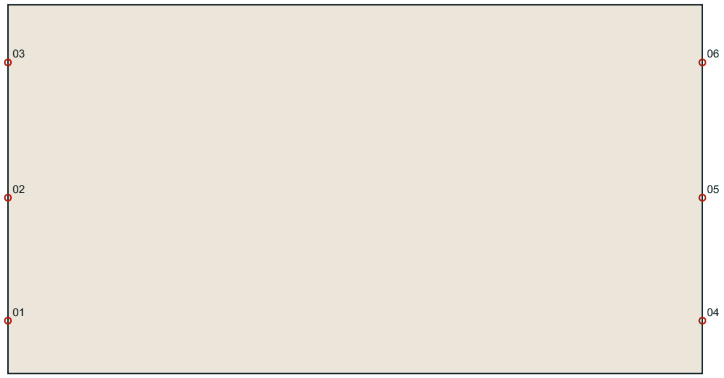
[picture p28: figure]

D2 - проект для контрольного образца. Не серийный допуск. Размеры мм; сверить контрольные условия. | 38

(0,0): чистовой угол; u вправо, v вверх

ID | u | v | n | Вход | Ø | Глуб. | Соедин.
QB.01 | 0.0 | 43.0 | 8.0 | u0 | 5 | 38 | J65
QB.02 | 0.0 | 143.0 | 8.0 | u0 | 5 | 38 | J66
QB.03 | 0.0 | 253.0 | 8.0 | u0 | 5 | 38 | J67
QB.04 | 564.6 | 43.0 | 8.0 | uMAX | 5 | 38 | J68
QB.05 | 564.6 | 143.0 | 8.0 | uMAX | 5 | 38 | J69
QB.06 | 564.6 | 253.0 | 8.0 | uMAX | 5 | 38 | J70

n: пласт; u/v: торец. Глубина от поверхности входа.

Ø7: зенковка Ø10 90°, 1,5 мм. Торец Ø5 глубина 38.

Кромка 0,4: сверлить от чистовой базы; не зеркалить без пересчёта.

# F / Фасад ящика / 618 x 100 x 16

D2 - проект для контрольного образца. Не серийный допуск. Размеры мм; сверить контрольные условия. | 39

(0,0): чистовой угол; u вправо, v вверх

01

02

03

04

ID | u | v | n | Вход | Ø | Глуб. | Соедин.
F.01 | 18.7 | 28.0 | 0.0 | n0 | 7 | 16 | J71
F.02 | 18.7 | 78.0 | 0.0 | n0 | 7 | 16 | J72
F.03 | 599.3 | 28.0 | 0.0 | n0 | 7 | 16 | J73
F.04 | 599.3 | 78.0 | 0.0 | n0 | 7 | 16 | J74

Паз (309;72), 110x24, ось u, сквозной

n: пласт; u/v: торец. Глубина от поверхности входа.

Ø7: зенковка Ø10 90°, 1,5 мм. Торец Ø5 глубина 38.

Кромка 0,4: сверлить от чистовой базы; не зеркалить без пересчёта.

# PB / Съёмная площадка AIRSTEP / 500 x 220 x 16

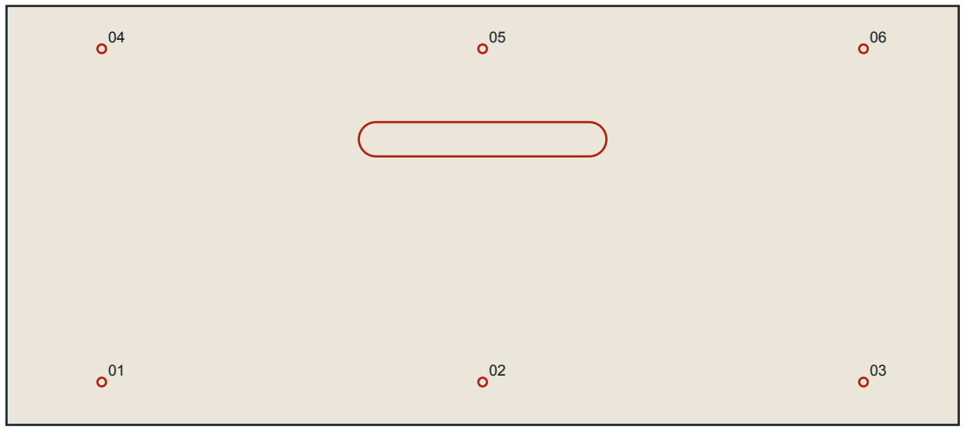
[picture p29: figure]

D2 - проект для контрольного образца. Не серийный допуск. Размеры мм; сверить контрольные условия. | 40

(0,0): чистовой угол; u вправо, v вверх

ID | u | v | n | Вход | Ø | Глуб. | Соедин.
PB.01 | 50.0 | 22.5 | 16.0 | nMAX | 4.5 | 16 | J75
PB.02 | 250.0 | 22.5 | 16.0 | nMAX | 4.5 | 16 | J76
PB.03 | 450.0 | 22.5 | 16.0 | nMAX | 4.5 | 16 | J77
PB.04 | 50.0 | 197.5 | 16.0 | nMAX | 4.5 | 16 | J78
PB.05 | 250.0 | 197.5 | 16.0 | nMAX | 4.5 | 16 | J79
PB.06 | 450.0 | 197.5 | 16.0 | nMAX | 4.5 | 16 | J80

Паз (250;150), 130x18, ось u, сквозной

n: пласт; u/v: торец. Глубина от поверхности входа.

Ø7: зенковка Ø10 90°, 1,5 мм. Торец Ø5 глубина 38.

Кромка 0,4: сверлить от чистовой базы; не зеркалить без пересчёта.

# PF1 / Опора педалборда 1 / 500 x 35 x 16

D2 - проект для контрольного образца. Не серийный допуск. Размеры мм; сверить контрольные условия. | 41

(0,0): чистовой угол; u вправо, v вверх

01 | 02 | 03
ID | u | v | n | Вход | Ø | Глуб. | Соедин.
PF1.01 | 50.0 | 17.5 | 16.0 | nMAX | 2.5 | 12 | J75
PF1.02 | 250.0 | 17.5 | 16.0 | nMAX | 2.5 | 12 | J76
PF1.03 | 450.0 | 17.5 | 16.0 | nMAX | 2.5 | 12 | J77

n: пласт; u/v: торец. Глубина от поверхности входа.

Ø7: зенковка Ø10 90°, 1,5 мм. Торец Ø5 глубина 38.

Кромка 0,4: сверлить от чистовой базы; не зеркалить без пересчёта.

# PF2 / Опора педалборда 2 / 500 x 35 x 16

D2 - проект для контрольного образца. Не серийный допуск. Размеры мм; сверить контрольные условия. | 42

(0,0): чистовой угол; u вправо, v вверх

01 | 02 | 03
ID | u | v | n | Вход | Ø | Глуб. | Соедин.
PF2.01 | 50.0 | 17.5 | 16.0 | nMAX | 2.5 | 12 | J78
PF2.02 | 250.0 | 17.5 | 16.0 | nMAX | 2.5 | 12 | J79
PF2.03 | 450.0 | 17.5 | 16.0 | nMAX | 2.5 | 12 | J80

n: пласт; u/v: торец. Глубина от поверхности входа.

Ø7: зенковка Ø10 90°, 1,5 мм. Торец Ø5 глубина 38.

Кромка 0,4: сверлить от чистовой базы; не зеркалить без пересчёта.

# Соединения / координаты начала и направления

D2 - проект для контрольного образца. Не серийный допуск. Размеры мм; сверить контрольные условия. | 43

J01 L → D C7 [0, 24, 50] [1, 0, 0]

J02 L → D C7 [0, 24, 180] [1, 0, 0]

J03 L → D C7 [0, 24, 310] [1, 0, 0]

J04 L → K C7 [0, 228, 50] [1, 0, 0]

J05 L → K C7 [0, 228, 180] [1, 0, 0]

J06 L → K C7 [0, 228, 310] [1, 0, 0]

J07 L → V C7 [0, 262, 352] [1, 0, 0]

J08 L → V C7 [0, 302, 352] [1, 0, 0]

J09 L → U C7 [0, 700, 352] [1, 0, 0]

J10 L → U C7 [0, 740, 352] [1, 0, 0]

J11 L → KF C7 [0, 155, 8] [1, 0, 0]

J12 L → KF C7 [0, 205, 8] [1, 0, 0]

J13 L → KR C7 [0, 155, 352] [1, 0, 0]

J14 L → KR C7 [0, 205, 352] [1, 0, 0]

J15 R → D C7 [654, 24, 50] [-1, 0, 0]

J16 R → D C7 [654, 24, 180] [-1, 0, 0]

J17 R → D C7 [654, 24, 310] [-1, 0, 0]

J18 R → K C7 [654, 228, 50] [-1, 0, 0]

J19 R → K C7 [654, 228, 180] [-1, 0, 0]

J20 R → K C7 [654, 228, 310] [-1, 0, 0]

J21 R → V C7 [654, 262, 352] [-1, 0, 0]

J22 R → V C7 [654, 302, 352] [-1, 0, 0]

J23 R → U C7 [654, 700, 352] [-1, 0, 0]

J24 R → U C7 [654, 740, 352] [-1, 0, 0]

J25 R → KF C7 [654, 155, 8] [-1, 0, 0]

J26 R → KF C7 [654, 205, 8] [-1, 0, 0]

J27 R → KR C7 [654, 155, 352] [-1, 0, 0]

J28 R → KR C7 [654, 205, 352] [-1, 0, 0]

J29 K → KF S4 [100, 236, 8] [0, -1, 0]

J30 K → KF S4 [250, 236, 8] [0, -1, 0]

J31 K → KF S4 [400, 236, 8] [0, -1, 0]

J32 K → KF S4 [550, 236, 8] [0, -1, 0]

J33 K → KR S4 [100, 236, 352] [0, -1, 0]

J34 K → KR S4 [250, 236, 352] [0, -1, 0]

J35 K → KR S4 [400, 236, 352] [0, -1, 0]

J36 K → KR S4 [550, 236, 352] [0, -1, 0]

J37 T → L C7 [8, 800, 50] [0, -1, 0]

J38 T → L C7 [8, 800, 180] [0, -1, 0]

J39 T → L C7 [8, 800, 310] [0, -1, 0]

J40 T → R C7 [646, 800, 50] [0, -1, 0]

# Соединения / координаты начала и направления

D2 - проект для контрольного образца. Не серийный допуск. Размеры мм; сверить контрольные условия. | 44

J41 T → R C7 [646, 800, 180] [0, -1, 0]

J42 T → R C7 [646, 800, 310] [0, -1, 0]

J43 D → E1 S4 [70, 32, 45] [0, -1, 0]

J44 D → E1 S4 [327, 32, 45] [0, -1, 0]

J45 D → E1 S4 [584, 32, 45] [0, -1, 0]

J46 GB → E1 S4 [700, 32, 45] [0, -1, 0]

J47 GB → E1 S4 [790, 32, 45] [0, -1, 0]

J48 D → E2 S4 [70, 32, 315] [0, -1, 0]

J49 D → E2 S4 [327, 32, 315] [0, -1, 0]

J50 D → E2 S4 [584, 32, 315] [0, -1, 0]

J51 GB → E2 S4 [700, 32, 315] [0, -1, 0]

J52 GB → E2 S4 [790, 32, 315] [0, -1, 0]

J53 GB → G1 S4 [700, 16, 130] [0, 1, 0]

J54 GB → G1 S4 [790, 16, 130] [0, 1, 0]

J55 GB → G2 S4 [700, 16, 230] [0, 1, 0]

J56 GB → G2 S4 [790, 16, 230] [0, 1, 0]

J57 R → GC1 C7 [638, 578, 108] [1, 0, 0]

J58 R → GC1 C7 [638, 622, 108] [1, 0, 0]

J59 GN → GC1 C7 [710, 666, 108] [0, -1, 0]

J60 GN → GC1 C7 [790, 666, 108] [0, -1, 0]

J61 R → GC2 C7 [638, 578, 252] [1, 0, 0]

J62 R → GC2 C7 [638, 622, 252] [1, 0, 0]

J63 GN → GC2 C7 [710, 666, 252] [0, -1, 0]

J64 GN → GC2 C7 [790, 666, 252] [0, -1, 0]

J65 QL → QB C7 [28.7, 50, 75] [1, 0, 0]

J66 QL → QB C7 [28.7, 50, 175] [1, 0, 0]

J67 QL → QB C7 [28.7, 50, 285] [1, 0, 0]

J68 QR → QB C7 [625.3, 50, 75] [-1, 0, 0]

J69 QR → QB C7 [625.3, 50, 175] [-1, 0, 0]

J70 QR → QB C7 [625.3, 50, 285] [-1, 0, 0]

J71 F → QL C7 [36.7, 64, 16] [0, 0, 1]

J72 F → QL C7 [36.7, 114, 16] [0, 0, 1]

J73 F → QR C7 [617.3, 64, 16] [0, 0, 1]

J74 F → QR C7 [617.3, 114, 16] [0, 0, 1]

J75 PB → PF1 S4 [127, 90, 87.5] [0, -1, 0]

J76 PB → PF1 S4 [327, 90, 87.5] [0, -1, 0]

J77 PB → PF1 S4 [527, 90, 87.5] [0, -1, 0]

J78 PB → PF2 S4 [127, 90, 262.5] [0, -1, 0]

J79 PB → PF2 S4 [327, 90, 262.5] [0, -1, 0]

J80 PB → PF2 S4 [527, 90, 262.5] [0, -1, 0]

# Контрольный образец: что должен проверить изготовитель

D2 - проект для контрольного образца. Не серийный допуск. Размеры мм; сверить контрольные условия. | 45
1. Размеры после кромления ±0,3; разность диагоналей корпуса не более 1 мм; перпендикулярность.
2. Пилот/зенковку сверить на обрезке с фактическим конфирматом. Не допускать расщепления/срыва.
3. Присадку направляющих проверить по приобретённой паре; ход не заедает, защёлки срабатывают.
4. Подвижный узел взвесить: с содержимым ≤10 кг. 50 циклов хода без перекоса и ослабления крепежа.
5. Полка: эквивалент груза 20 кг, распределённый как усилитель; измерить прогиб сразу и через 24 часа.
6. Педалборд на полу: приложить 300 Н в зоне выключателей, без человека сверху; проверить трещины.
7. Гитара: сначала эквивалент 5 кг на нижних опорах и 30 Н к вилке в разные стороны, затем примерка.
8. Противоопрокидывающую связь выполнить до испытания толчком. Анкер подбирать под стену, не по фото.
9. Стендовые пробы выполняет изготовитель безопасно, с ограждением/страховкой; инструментами не испытывать.
10. Вентиляцию решить отдельно перед эксплуатацией. Не считать любой набор отверстий достаточным.

Без этих проверок маркировка выпуска остаётся HOLD. Физические испытания в этой работе не выполнялись.

# Фурнитура / стоимость покупки упаковок

D2 - проект для контрольного образца. Не серийный допуск. Размеры мм; сверить контрольные условия. | 46
Код / наименование | Нужно / покупка | Сумма, руб.
SL / BOYARD DB4501Zn/300, пара | 1 / 1 пара | 275.97

Открыть карточку товара (ссылка) (https://www.boyard.biz/catalog/slide_systems/db4501zn-300.html)

C7 / Конфирмат 7×50 Timtech | 52 / 6 пакетов по 10 | 558.00

Открыть карточку товара (ссылка) (https://www.ozon.ru/product/konfirmat-7h50-mm-10sht-mebelnyy-vint-styazhka-golovka-potaynaya-pod-shestigrannik-evrovint-1317687131/)

S4 / Шуруп по дереву 4×30 PZ2, полукруглая головка | 28 / 250 шт. | 1020.00

Открыть карточку товара (ссылка) (https://letfix.ru/shop/fasteners/screws/screws_for_wood_polukr_yzn_4x30.html)

S16 / Шуруп по дереву 3,5×16 PZ2, полукруглая головка | 10 / 250 шт. | 441.00

Открыть карточку товара (ссылка) (https://letfix.ru/shop/fasteners/screws/screws_for_wood_polukr_yzn_3-5x16.html)

STR / Fortisflex КСВ 16×310 чёрный, 59295 | 9 / 20 шт. | 797.80

Открыть карточку товара (ссылка) (https://www.radioelementy.ru/catalog/pod-zakaz/styazhka-velkro-ksv-16kh310-chern-fortisflex-59295/)

VEL / UNIBOB 49310, крючок+петля 20 мм × 1 м | 1 / 1 комплект | 232.80

Открыть карточку товара (ссылка) (https://lipkaya-lenta.ru/katalog/lipuchki-zastezhki/lenta-lipuchka-unibob-kruchok-petlya-samokleyashayasya.html)

FEL / Pacific РС6055BR, войлок 3 мм, 35×55, 12 шт. | 12 / 2 листа / 24 накладки | 104.00

Открыть карточку товара (ссылка) (https://amix.biz/catalog/nozhki_mebelnye/podpyatniki_mebelnye/rs6055br/)

RUB / Резиновая самоклеящаяся полоса 29×3 мм, 6 м | 1 / 1 рулон | 1222.00

Открыть карточку товара (ссылка) (https://m.integration.vs.market.yandex.net/card/samokleyashchayasya-rezinovaya-taktilnaya-polosa-protiv-skolzheniya-29-mm-kh-3-mm-tsvet-seryy-dlina-6-metrov/1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)

W1 / fischer SXRL 10×160 FUS, 522724 | 2 / 2 шт. / проверить поштучную продажу | 578.50

Открыть карточку товара (ссылка) (https://fischersystem.ru/catalog/fasadnye_dyubeli/522724/)

W2 / Шайба DIN 9021 M10, оцинкованная | 2 / 10 шт. | 78.00

Открыть карточку товара (ссылка) (https://www.stroysa.tomsk.ru/catalog/metrika/shayba_din_9021_uvelichennaya_m10_10sht/)

Фурнитура: 5308.07 руб. W1 рассчитан по 2 шт.; поштучный отпуск надо подтвердить.

Ozon / Яндекс Маркет / РФ-поставщики. Развёрнутые условия и упаковки: output-d2/hardware.html.

# Общая смета / стоимость изготовления предварительная

D2 - проект для контрольного образца. Не серийный допуск. Размеры мм; сверить контрольные условия. | 47
ЛДСП белый 16 мм, 2500×1830, 1 лист (https://twowin.ru/product/ldsp-16mm-2500kh1830-belyy-0110-resm-kronoshpan/) | 2130.00 руб.
Раскрой 30 деталей ЛДСП 16 мм (https://family96.ru/raspil-ldsp/) | 700.00 руб.
Кромление всех деталей 16 мм (https://family96.ru/raspil-ldsp/) | 2024.00 руб.
Материал кромки 0,4 мм + герметизация пазов | 600.00 руб.
Присадка всех отверстий (https://drevplit96.ru/services/raspil/) | 4450.00 руб.
Фрезеровка вилки, ручки и трёх пазов | 2000.00 руб.
Сборка и контрольные испытания образца | 2500.00 руб.

Фурнитура 5308.07; итог с целыми розничными упаковками: 19712.07 руб.

Сценарий цеха (метизы поштучно): 18382.95 руб.

Это не фиксированная цена заказа: ЧПУ, присадка, кромка и сборка должны попасть в предложение цеха.

Доставка, монтаж в стену, техника и опциональные органайзеры не включены. Заказы не оформлялись.

Не покупать 50 анкеров: если поставщик не отпускает 2, цех закупает поштучно или пересчитывает узел.
