boxforkonstantin-max/guitar-stand/ldsp-onstage/output/pdf/workstation_D1.pdf

WORKSTATION / ЛДСП 16 / D1

# Сборка и ограничения

D1 - НЕ В ПРОИЗВОДСТВО. Вентиляция и держатель гитары не завершены. Размеры в мм. | 1

D1 - инженерный прототип. НЕ ВЫПУСК В ПРОИЗВОДСТВО: вентиляция отложена, нагрузки/устойчивость не испытаны.

Компактность согласована; зазоры руководства BOSS не соблюдены. Отверстия вентиляции не добавлены.

Все размеры деталей - после кромления. ПВХ 0,4 мм по 4 сторонам; заготовка на 0,8 мм меньше по каждой оси.

Координаты присадки от чистового угла. Выполнять после кромления либо пересчитать базу на 0,4 мм.

Конфирмат 7x50: пласт Ø7 сквозное + зенковка Ø10 90° до заподлицо; торец Ø5 глубина 38.

Сначала пробное соединение на обрезке выбранной ЛДСП/винта. Фактическая толщина плиты должна быть 16 мм.

Кассета извлекается целиком: ножки приподнять над дном, поставить на пол. Не нажимать ногой внутри корпуса.

Плашка A - интерфейс держателя, не готовый держатель гитары. Его посадку/высоту проверить по образцу.

Гитару не подвешивать до проверки держателя и устойчивости, в том числе при снятой Katana.

Прямые углы ЛДСП: снять остроту кромки. Все открытые торцы прорезей герметизировать/облицевать.

Габарит корпуса 654 x 360 x 800 (без мягкой прокладки под опорами).

Полка Katana: верх Y192; верх усилителя Y590; до низа столешницы 194 мм.

Кассета: чистый зазор до полки над AIRSTEP 75 мм; играть на полу, не внутри ниши.

Модель и присадка созданы из одного build.py. Основной прототип R6 не изменён.

Оси сборки: X вправо, Y вверх, Z назад. Начало: левый передний нижний угол корпуса.

Элементы A/GH не определяют готовность бокового хранения: до примерки гитары НЕ использовать.

# Схема компоновки / условно прозрачные виды

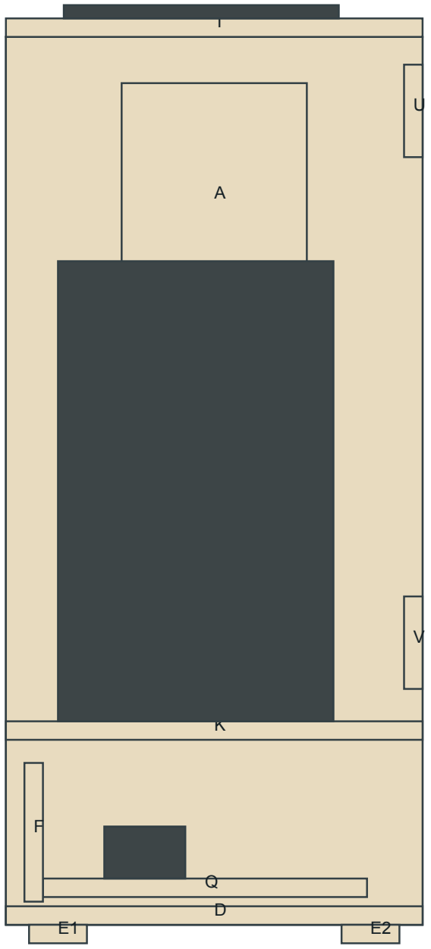
[picture p30: figure]

D1 - НЕ В ПРОИЗВОДСТВО. Вентиляция и держатель гитары не завершены. Размеры в мм. | 2
L | R

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
L | TDK | R

VU

Q

F

E1

E2

A

Спереди: 654 x 800 | Сбоку: глубина 360

### Сверху

# Детали и кромление

D1 - НЕ В ПРОИЗВОДСТВО. Вентиляция и держатель гитары не завершены. Размеры в мм. | 3

Кромка 0,4 мм на все 4 наружные стороны. u/v - оси чертежа детали.

Раскрой не оптимизирован под лист: заказать детали из остатка декора либо раскрой у исполнителя.

L Левая боковина | 1 шт 360 x 768 x 16 | распил 359.2 x 767.2 | 13 сверлений
R Правая боковина | 1 шт 360 x 768 x 16 | распил 359.2 x 767.2 | 17 сверлений
T Площадка ноутбука | 1 шт 654 x 360 x 16 | распил 653.2 x 359.2 | 6 сверлений
D Дно корпуса | 1 шт 622 x 360 x 16 | распил 621.2 x 359.2 | 12 сверлений
K Полка Katana | 1 шт 622 x 360 x 16 | распил 621.2 x 359.2 | 6 сверлений
V Задняя нижняя связь | 1 шт 622 x 80 x 16 | распил 621.2 x 79.2 | 4 сверлений
U Задняя верхняя связь | 1 шт 622 x 80 x 16 | распил 621.2 x 79.2 | 4 сверлений
Q Дека съёмной кассеты | 1 шт 590 x 280 x 16 | распил 589.2 x 279.2 | 8 сверлений
F Фасад кассеты | 1 шт 618 x 120 x 16 | распил 617.2 x 119.2 | 4 сверлений
E1 Передняя опорная планка | 1 шт 654 x 50 x 16 | распил 653.2 x 49.2 | 3 сверлений
E2 Задняя опорная планка | 1 шт 654 x 50 x 16 | распил 653.2 x 49.2 | 3 сверлений
A Сменная плашка держателя | 1 шт 160 x 200 x 16 | распил 159.2 x 199.2 | 4 сверлений

# L / Левая боковина / 360 x 768 x 16

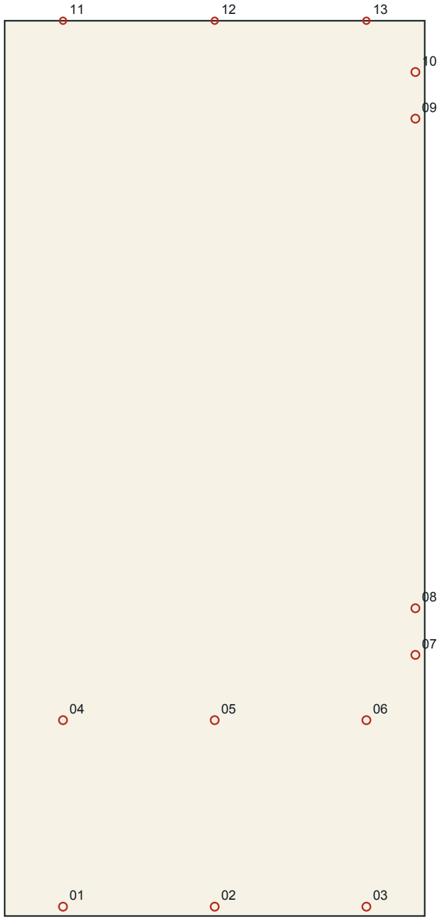
[picture p31: figure]

D1 - НЕ В ПРОИЗВОДСТВО. Вентиляция и держатель гитары не завершены. Размеры в мм. | 4

(0,0) - чистовой угол; u вправо, v вверх

u = 360; v = 768

ID | u | v | n | Вход | Ø | Глуб. | Соединение
L.01 | 50 | 8 | 0 n0 | 7 | 16 | J01
L.02 | 180 | 8 | 0 n0 | 7 | 16 | J02
L.03 | 310 | 8 | 0 n0 | 7 | 16 | J03
L.04 | 50 | 168 | 0 n0 | 7 | 16 | J04
L.05 | 180 | 168 | 0 n0 | 7 | 16 | J05
L.06 | 310 | 168 | 0 n0 | 7 | 16 | J06
L.07 | 352 | 224 | 0 n0 | 7 | 16 | J07
L.08 | 352 | 264 | 0 n0 | 7 | 16 | J08
L.09 | 352 | 684 | 0 n0 | 7 | 16 | J09
L.10 | 352 | 724 | 0 n0 | 7 | 16 | J10
L.11 | 50 | 768 | 8 vMAX | 5 | 38 | J21
L.12 | 180 | 768 | 8 vMAX | 5 | 38 | J22
L.13 | 310 | 768 | 8 vMAX | 5 | 38 | J23

n=0 / nMAX: вход с пласти; u/v: вход с соответствующего торца.

Ø7: зенковка Ø10 90°; Ø5 в торце: ось на половине толщины (8).

Глубина указана от поверхности входа, не от противоположной стороны.

На графике показана проекция центров. Торцевое сверление - по таблице.

Все отверстия на графике; эта таблица: часть 1.

# R / Правая боковина / 360 x 768 x 16

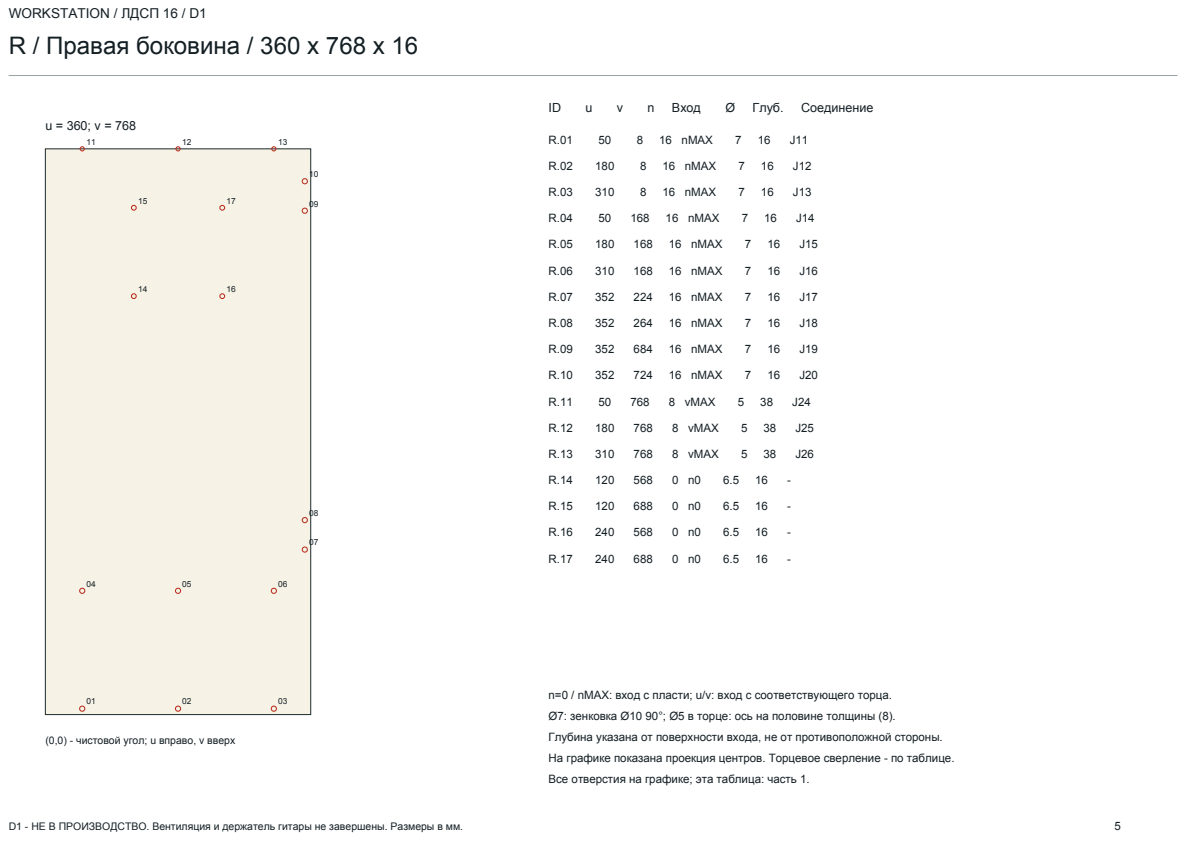
[picture p32: page 5]

n=0 / nMAX: вход с пласти; u/v: вход с соответствующего торца.
Ø7: зенковка Ø10 90°; Ø5 в торце: ось на половине толщины (8).

Глубина указана от поверхности входа, не от противоположной стороны.

(0,0) - чистовой угол; u вправо, v вверх

На графике показана проекция центров. Торцевое сверление - по таблице.

Все отверстия на графике; эта таблица: часть 1.

# T / Площадка ноутбука / 654 x 360 x 16

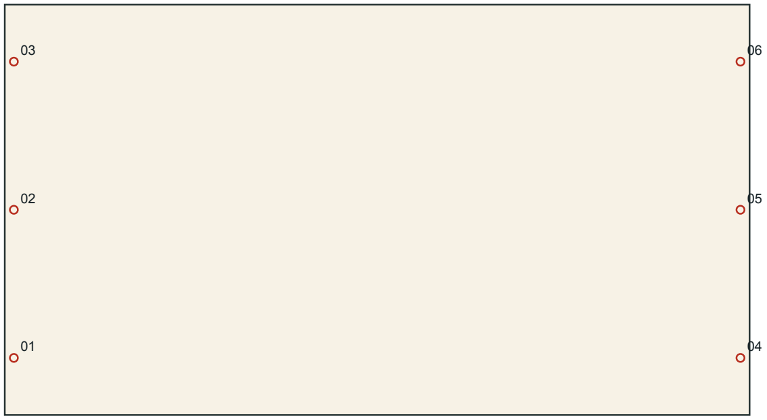
[picture p33: figure]

D1 - НЕ В ПРОИЗВОДСТВО. Вентиляция и держатель гитары не завершены. Размеры в мм. | 6

(0,0) - чистовой угол; u вправо, v вверх

u = 654; v = 360

ID | u | v | n | Вход | Ø | Глуб. | Соединение
T.01 | 8 | 50 | 16 nMAX | 7 | 16 | J21
T.02 | 8 | 180 | 16 nMAX | 7 | 16 | J22
T.03 | 8 | 310 | 16 nMAX | 7 | 16 | J23
T.04 | 646 | 50 | 16 nMAX | 7 | 16 | J24
T.05 | 646 | 180 | 16 nMAX | 7 | 16 | J25
T.06 | 646 | 310 | 16 nMAX | 7 | 16 | J26

n=0 / nMAX: вход с пласти; u/v: вход с соответствующего торца.

Ø7: зенковка Ø10 90°; Ø5 в торце: ось на половине толщины (8).

Глубина указана от поверхности входа, не от противоположной стороны.

На графике показана проекция центров. Торцевое сверление - по таблице.

Все отверстия на графике; эта таблица: часть 1.

# D / Дно корпуса / 622 x 360 x 16

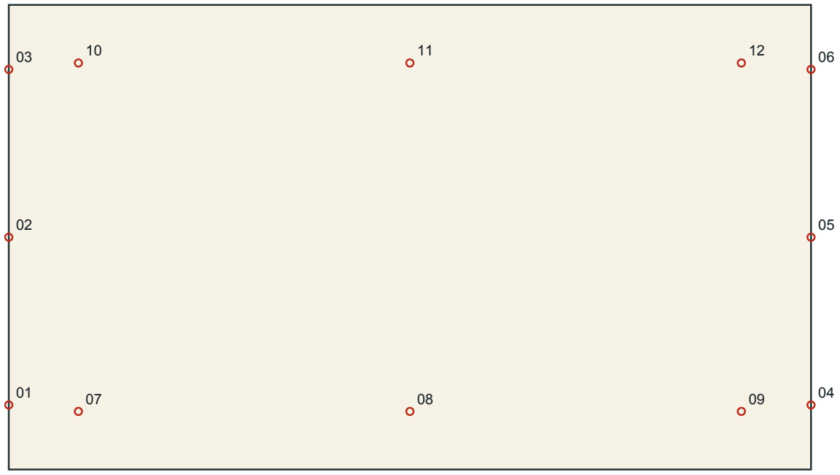
[picture p34: figure]

D1 - НЕ В ПРОИЗВОДСТВО. Вентиляция и держатель гитары не завершены. Размеры в мм. | 7

(0,0) - чистовой угол; u вправо, v вверх

u = 622; v = 360

ID | u | v | n | Вход | Ø | Глуб. | Соединение
D.01 | 0 | 50 | 8 u0 | 5 | 38 | J01
D.02 | 0 | 180 | 8 u0 | 5 | 38 | J02
D.03 | 0 | 310 | 8 u0 | 5 | 38 | J03
D.04 | 622 | 50 | 8 uMAX | 5 | 38 | J11
D.05 | 622 | 180 | 8 uMAX | 5 | 38 | J12
D.06 | 622 | 310 | 8 uMAX | 5 | 38 | J13
D.07 | 54 | 45 | 16 nMAX | 4.5 | 16 | J31
D.08 | 311 | 45 | 16 nMAX | 4.5 | 16 | J32
D.09 | 568 | 45 | 16 nMAX | 4.5 | 16 | J33
D.10 | 54 | 315 | 16 nMAX | 4.5 | 16 | J34
D.11 | 311 | 315 | 16 nMAX | 4.5 | 16 | J35
D.12 | 568 | 315 | 16 nMAX | 4.5 | 16 | J36

n=0 / nMAX: вход с пласти; u/v: вход с соответствующего торца.

Ø7: зенковка Ø10 90°; Ø5 в торце: ось на половине толщины (8).

Глубина указана от поверхности входа, не от противоположной стороны.

На графике показана проекция центров. Торцевое сверление - по таблице.

Все отверстия на графике; эта таблица: часть 1.

# K / Полка Katana / 622 x 360 x 16

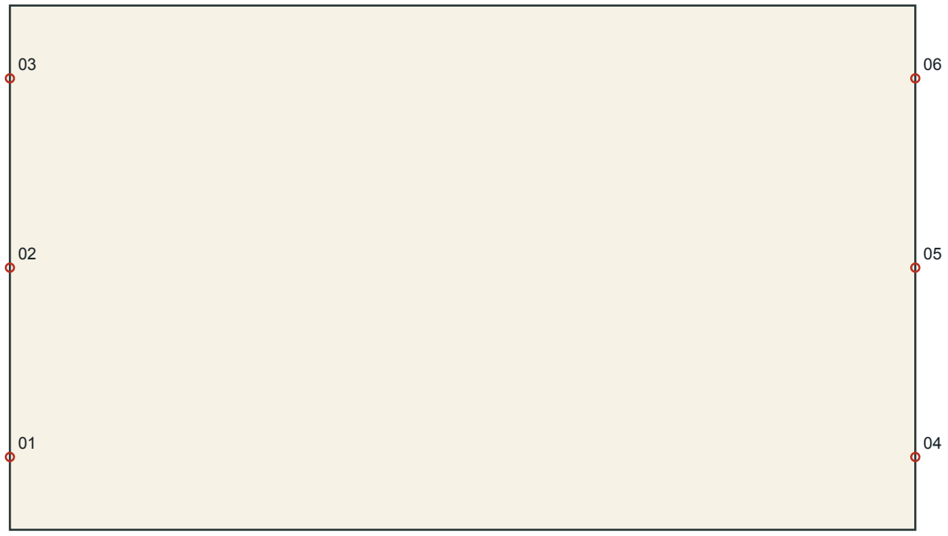
[picture p35: figure]

D1 - НЕ В ПРОИЗВОДСТВО. Вентиляция и держатель гитары не завершены. Размеры в мм. | 8

(0,0) - чистовой угол; u вправо, v вверх

u = 622; v = 360

ID | u | v | n | Вход | Ø | Глуб. | Соединение
K.01 | 0 | 50 | 8 u0 | 5 | 38 | J04
K.02 | 0 | 180 | 8 u0 | 5 | 38 | J05
K.03 | 0 | 310 | 8 u0 | 5 | 38 | J06
K.04 | 622 | 50 | 8 uMAX | 5 | 38 | J14
K.05 | 622 | 180 | 8 uMAX | 5 | 38 | J15
K.06 | 622 | 310 | 8 uMAX | 5 | 38 | J16

n=0 / nMAX: вход с пласти; u/v: вход с соответствующего торца.

Ø7: зенковка Ø10 90°; Ø5 в торце: ось на половине толщины (8).

Глубина указана от поверхности входа, не от противоположной стороны.

На графике показана проекция центров. Торцевое сверление - по таблице.

Все отверстия на графике; эта таблица: часть 1.

# V / Задняя нижняя связь / 622 x 80 x 16

D1 - НЕ В ПРОИЗВОДСТВО. Вентиляция и держатель гитары не завершены. Размеры в мм. | 9

(0,0) - чистовой угол; u вправо, v вверх

u = 622; v = 80

01

02

03

04

ID | u | v | n | Вход | Ø | Глуб. | Соединение
V.01 | 0 | 20 | 8 u0 | 5 | 38 | J07
V.02 | 0 | 60 | 8 u0 | 5 | 38 | J08
V.03 | 622 | 20 | 8 uMAX | 5 | 38 | J17
V.04 | 622 | 60 | 8 uMAX | 5 | 38 | J18

n=0 / nMAX: вход с пласти; u/v: вход с соответствующего торца.

Ø7: зенковка Ø10 90°; Ø5 в торце: ось на половине толщины (8).

Глубина указана от поверхности входа, не от противоположной стороны.

На графике показана проекция центров. Торцевое сверление - по таблице.

Все отверстия на графике; эта таблица: часть 1.

# U / Задняя верхняя связь / 622 x 80 x 16

D1 - НЕ В ПРОИЗВОДСТВО. Вентиляция и держатель гитары не завершены. Размеры в мм. | 10

(0,0) - чистовой угол; u вправо, v вверх

u = 622; v = 80

01

02

03

04

ID | u | v | n | Вход | Ø | Глуб. | Соединение
U.01 | 0 | 20 | 8 u0 | 5 | 38 | J09
U.02 | 0 | 60 | 8 u0 | 5 | 38 | J10
U.03 | 622 | 20 | 8 uMAX | 5 | 38 | J19
U.04 | 622 | 60 | 8 uMAX | 5 | 38 | J20

n=0 / nMAX: вход с пласти; u/v: вход с соответствующего торца.

Ø7: зенковка Ø10 90°; Ø5 в торце: ось на половине толщины (8).

Глубина указана от поверхности входа, не от противоположной стороны.

На графике показана проекция центров. Торцевое сверление - по таблице.

Все отверстия на графике; эта таблица: часть 1.

# Q / Дека съёмной кассеты / 590 x 280 x 16

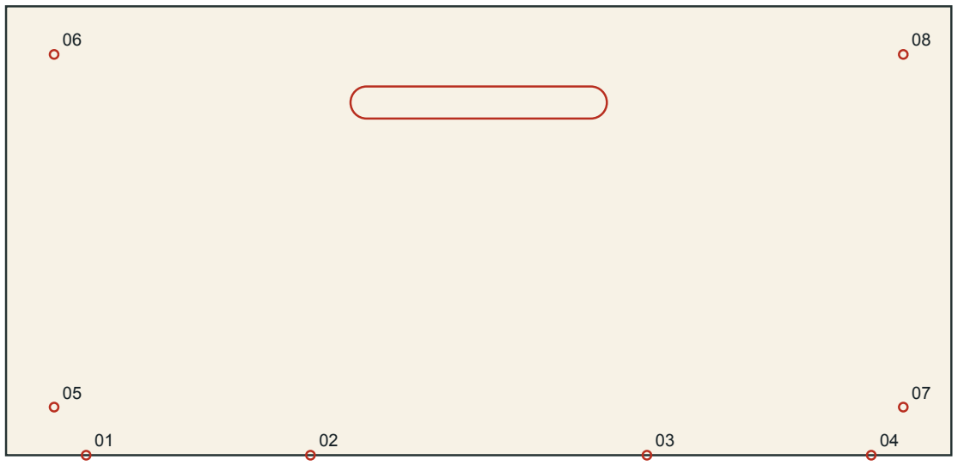
[picture p36: figure]

D1 - НЕ В ПРОИЗВОДСТВО. Вентиляция и держатель гитары не завершены. Размеры в мм. | 11

(0,0) - чистовой угол; u вправо, v вверх

u = 590; v = 280

ID | u | v | n | Вход | Ø | Глуб. | Соединение
Q.01 | 50 | 0 | 8 v0 | 5 | 38 | J27
Q.02 | 190 | 0 | 8 v0 | 5 | 38 | J28
Q.03 | 400 | 0 | 8 v0 | 5 | 38 | J29
Q.04 | 540 | 0 | 8 v0 | 5 | 38 | J30
Q.05 | 30 | 30 | 0 n0 | 2.5 | 10 | -
Q.06 | 30 | 250 | 0 n0 | 2.5 | 10 | -
Q.07 | 560 | 30 | 0 n0 | 2.5 | 10 | -
Q.08 | 560 | 250 | 0 n0 | 2.5 | 10 | -

Паз: центр (295,220), 160 x 20, ось u, сквозной.

n=0 / nMAX: вход с пласти; u/v: вход с соответствующего торца.

Ø7: зенковка Ø10 90°; Ø5 в торце: ось на половине толщины (8).

Глубина указана от поверхности входа, не от противоположной стороны.

На графике показана проекция центров. Торцевое сверление - по таблице.

Все отверстия на графике; эта таблица: часть 1.

# F / Фасад кассеты / 618 x 120 x 16

D1 - НЕ В ПРОИЗВОДСТВО. Вентиляция и держатель гитары не завершены. Размеры в мм. | 12

(0,0) - чистовой угол; u вправо, v вверх

u = 618; v = 120

01 | 02 | 03 | 04
ID | u | v | n | Вход | Ø | Глуб. | Соединение
F.01 | 64 | 12 | 0 n0 | 7 | 16 | J27
F.02 | 204 | 12 | 0 n0 | 7 | 16 | J28
F.03 | 414 | 12 | 0 n0 | 7 | 16 | J29
F.04 | 554 | 12 | 0 n0 | 7 | 16 | J30

Паз: центр (309,85), 110 x 24, ось u, сквозной.

n=0 / nMAX: вход с пласти; u/v: вход с соответствующего торца.

Ø7: зенковка Ø10 90°; Ø5 в торце: ось на половине толщины (8).

Глубина указана от поверхности входа, не от противоположной стороны.

На графике показана проекция центров. Торцевое сверление - по таблице.

Все отверстия на графике; эта таблица: часть 1.

# E1 / Передняя опорная планка / 654 x 50 x 16

D1 - НЕ В ПРОИЗВОДСТВО. Вентиляция и держатель гитары не завершены. Размеры в мм. | 13

(0,0) - чистовой угол; u вправо, v вверх

u = 654; v = 50

01 | 02 | 03
ID | u | v | n | Вход | Ø | Глуб. | Соединение
E1.01 | 70 | 25 | 16 nMAX | 2.5 | 12 | J31
E1.02 | 327 | 25 | 16 nMAX | 2.5 | 12 | J32
E1.03 | 584 | 25 | 16 nMAX | 2.5 | 12 | J33

n=0 / nMAX: вход с пласти; u/v: вход с соответствующего торца.

Ø7: зенковка Ø10 90°; Ø5 в торце: ось на половине толщины (8).

Глубина указана от поверхности входа, не от противоположной стороны.

На графике показана проекция центров. Торцевое сверление - по таблице.

Все отверстия на графике; эта таблица: часть 1.

# E2 / Задняя опорная планка / 654 x 50 x 16

D1 - НЕ В ПРОИЗВОДСТВО. Вентиляция и держатель гитары не завершены. Размеры в мм. | 14

(0,0) - чистовой угол; u вправо, v вверх

u = 654; v = 50

01 | 02 | 03
ID | u | v | n | Вход | Ø | Глуб. | Соединение
E2.01 | 70 | 25 | 16 nMAX | 2.5 | 12 | J34
E2.02 | 327 | 25 | 16 nMAX | 2.5 | 12 | J35
E2.03 | 584 | 25 | 16 nMAX | 2.5 | 12 | J36

n=0 / nMAX: вход с пласти; u/v: вход с соответствующего торца.

Ø7: зенковка Ø10 90°; Ø5 в торце: ось на половине толщины (8).

Глубина указана от поверхности входа, не от противоположной стороны.

На графике показана проекция центров. Торцевое сверление - по таблице.

Все отверстия на графике; эта таблица: часть 1.

# A / Сменная плашка держателя / 160 x 200 x 16

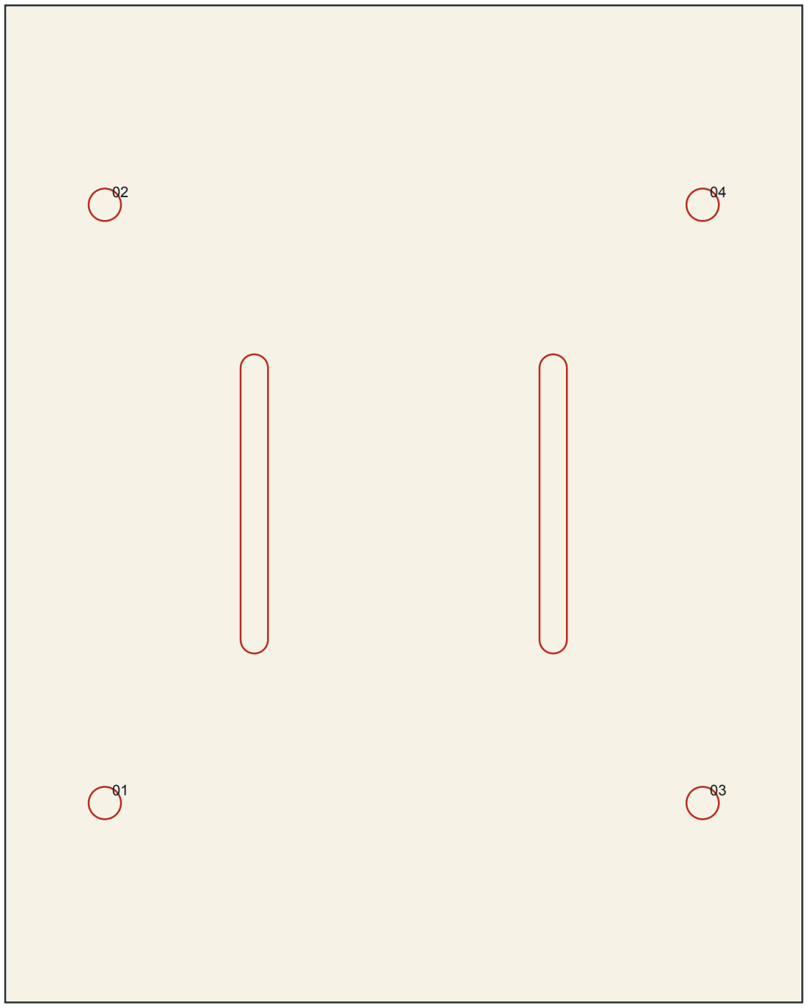
[picture p37: figure]

D1 - НЕ В ПРОИЗВОДСТВО. Вентиляция и держатель гитары не завершены. Размеры в мм. | 15

(0,0) - чистовой угол; u вправо, v вверх

u = 160; v = 200

ID | u | v | n | Вход | Ø | Глуб. | Соединение
A.01 | 20 | 40 | 0 n0 | 6.5 | 16 | -
A.02 | 20 | 160 | 0 n0 | 6.5 | 16 | -
A.03 | 140 | 40 | 0 n0 | 6.5 | 16 | -
A.04 | 140 | 160 | 0 n0 | 6.5 | 16 | -

Паз: центр (50,100), 60 x 5.5, ось v, сквозной.

Паз: центр (110,100), 60 x 5.5, ось v, сквозной.

n=0 / nMAX: вход с пласти; u/v: вход с соответствующего торца.

Ø7: зенковка Ø10 90°; Ø5 в торце: ось на половине толщины (8).

Глубина указана от поверхности входа, не от противоположной стороны.

На графике показана проекция центров. Торцевое сверление - по таблице.

Все отверстия на графике; эта таблица: часть 1.

# Соединения / оси крепежа

D1 - НЕ В ПРОИЗВОДСТВО. Вентиляция и держатель гитары не завершены. Размеры в мм. | 16

J01 L → D C7 начало [0, 24, 50] ось [1, 0, 0]

J02 L → D C7 начало [0, 24, 180] ось [1, 0, 0]

J03 L → D C7 начало [0, 24, 310] ось [1, 0, 0]

J04 L → K C7 начало [0, 184, 50] ось [1, 0, 0]

J05 L → K C7 начало [0, 184, 180] ось [1, 0, 0]

J06 L → K C7 начало [0, 184, 310] ось [1, 0, 0]

J07 L → V C7 начало [0, 240, 352] ось [1, 0, 0]

J08 L → V C7 начало [0, 280, 352] ось [1, 0, 0]

J09 L → U C7 начало [0, 700, 352] ось [1, 0, 0]

J10 L → U C7 начало [0, 740, 352] ось [1, 0, 0]

J11 R → D C7 начало [654, 24, 50] ось [-1, 0, 0]

J12 R → D C7 начало [654, 24, 180] ось [-1, 0, 0]

J13 R → D C7 начало [654, 24, 310] ось [-1, 0, 0]

J14 R → K C7 начало [654, 184, 50] ось [-1, 0, 0]

J15 R → K C7 начало [654, 184, 180] ось [-1, 0, 0]

J16 R → K C7 начало [654, 184, 310] ось [-1, 0, 0]

J17 R → V C7 начало [654, 240, 352] ось [-1, 0, 0]

J18 R → V C7 начало [654, 280, 352] ось [-1, 0, 0]

J19 R → U C7 начало [654, 700, 352] ось [-1, 0, 0]

J20 R → U C7 начало [654, 740, 352] ось [-1, 0, 0]

J21 T → L C7 начало [8, 800, 50] ось [0, -1, 0]

J22 T → L C7 начало [8, 800, 180] ось [0, -1, 0]

J23 T → L C7 начало [8, 800, 310] ось [0, -1, 0]

J24 T → R C7 начало [646, 800, 50] ось [0, -1, 0]

J25 T → R C7 начало [646, 800, 180] ось [0, -1, 0]

J26 T → R C7 начало [646, 800, 310] ось [0, -1, 0]

J27 F → Q C7 начало [82, 48, 16] ось [0, 0, 1]

J28 F → Q C7 начало [222, 48, 16] ось [0, 0, 1]

J29 F → Q C7 начало [432, 48, 16] ось [0, 0, 1]

J30 F → Q C7 начало [572, 48, 16] ось [0, 0, 1]

J31 D → E1 S4 начало [70, 32, 45] ось [0, -1, 0]

J32 D → E1 S4 начало [327, 32, 45] ось [0, -1, 0]

J33 D → E1 S4 начало [584, 32, 45] ось [0, -1, 0]

J34 D → E2 S4 начало [70, 32, 315] ось [0, -1, 0]

J35 D → E2 S4 начало [327, 32, 315] ось [0, -1, 0]

J36 D → E2 S4 начало [584, 32, 315] ось [0, -1, 0]

C7 = конфирмат 7x50; S4 = шуруп 4x30. Начало и ось в координатах сборки X/Y/Z.

Крепление плашки A: 4 M6x45; отверстия A.01–04 и R.14–17 соосны.

M6: две плиты 32 мм + шайбы с двух сторон + гайка; контролировать выход минимум двух витков.

# Сборка / крепёж / контроль

D1 - НЕ В ПРОИЗВОДСТВО. Вентиляция и держатель гитары не завершены. Размеры в мм. | 17
1. Закромить детали; проверить толщину и пробное соединение 7x50.
2. К D снизу приложить E1/E2; 6 шурупов 4x30 через Ø4,5 в D в пилоты E1/E2.
3. L/R соединить с D/K/V/U на 20 конфирматов. Пока не затягивать до конца.
4. Проверить диагонали корпуса; закрепить T шестью конфирматами. Затягивать без срыва ЛДСП.
5. Соединить F и Q четырьмя конфирматами. Установить четыре ножки высотой 8 мм.
6. Кассету вставлять без кабелей под её ножками. При извлечении слегка приподнимать, не тянуть разъём.
7. Прикрепить A четырьмя M6x45 с увеличенными шайбами с двух сторон и гайками DIN985.
8. GH ставить только после проверки его основания, высоты грифа и устойчивости. Не сверлить по фото.
9. Наклеить полосы липучки на деку и AIRSTEP, не перекрывая элементы обслуживания.
10. Кабель USB пропустить через паз Q; оставить свободную петлю для выноса кассеты на пол.
11. Провести контрольную сборку без оборудования: люфты, выход шурупов, качание, острые кромки.
12. До нагрузки оборудованием проверить прочность, устойчивость и вентиляцию. Не вставать на полки.

Фурнитура со ссылками: ../hardware.html. CAD с вычитанием отверстий: ../assembly.scad.

DXF: контуры ЧИСТОВЫЕ; слои EDGE_REFERENCE только справочные, не траектории сверления пласти.

Общая геометрия в model.json; диаметры/глубины в нём совпадают с этими таблицами.
