boxforkonstantin-max/guitar-stand/ldsp-onstage/output/hardware.html

# Фурнитура / D1

11.10.2026. Количество на одно изделие. Поисковые ссылки не являются выбранными товарами. Цены из поискового индекса, доставка не проверена. Не полный заказ к покупке: GH, M5, ножки и их шурупы требуют сверки образцов.

Код | Наименование | Количество | Ссылка | Примечание
C7 | Конфирмат 7x50 | 30 шт | Открыть (https://www.ozon.ru/product/konfirmat-7h50-mm-10sht-mebelnyy-vint-styazhka-golovka-potaynaya-pod-shestigrannik-evrovint-1317687131/) | 3 упаковки по 10; проверить геометрию головки; ориентир 249–279 руб из индекса
C0 | Заглушка под конфирмат | 30 шт | Открыть (https://www.ozon.ru/search/?text=заглушка+конфирмат+7x50+черная) | Поисковая ссылка; цвет по ЛДСП
S4 | Шуруп 4x30, полукруглая головка | 6 шт | Открыть (https://market.yandex.ru/search?text=шуруп+4х30+полукруглая+головка) | Поиск; крепление опорных планок; пилот Ø2,5x12
M6 | Болт M6x45 DIN 912 | 4 шт | Открыть (https://market.yandex.ru/search?text=болт+М6х45+DIN+912) | Поиск; плашка A; шайбы с двух сторон, гайка с нейлоном
W6 | Шайба увеличенная M6 DIN 9021 | 8 шт | Открыть (https://www.ozon.ru/search/?text=шайба+М6+DIN+9021) | Поиск; наружный диаметр 18 мм
N6 | Гайка M6 DIN 985 | 4 шт | Открыть (https://market.yandex.ru/search?text=гайка+М6+DIN+985) | Поиск; самоконтрящаяся
P8 | Резиновая ножка высота 8 мм | 4 шт | Открыть (https://www.ozon.ru/search/?text=ножка+резиновая+8+мм+под+шуруп) | Поиск; дека кассеты; Ø20–25; шуруп с заходом в плиту 10–12 мм, подобрать к ножке
S3 | Шуруп ножки Ø3–3,5 | 4 шт | Открыть (https://market.yandex.ru/search?text=шуруп+3.5х16+полукруглая) | Поиск; длина = толщина ножки под головкой + 10–12 мм; НЕ назначать 16 мм вслепую
EP | Нескользящая прокладка EPDM 1 мм | 0.066 м² | Открыть (https://www.ozon.ru/search/?text=резина+EPDM+лист+1+мм) | Поиск; под планки E1/E2, 2 полосы 654x50; увеличит высоту корпуса примерно на 1 мм
VC | Липучка 25 мм крючок + петля | 1 м комплекта | Открыть (https://www.ozon.ru/category/lenta-lipuchka-samokleyuschayasya/) | Категория, не выбранный SKU; на AIRSTEP 2 полосы 250 мм; не закрыть винты/ножки
VT | Стяжка-липучка 150x12 | 8 шт | Открыть (https://m.integration.vs.market.yandex.net/card/mnogorazovaya-styazhka-lipuchka-dlya-provodov-i-kabeley-150kh12-mm-tsvet-chernyy-20-sht/102473445874) | Карточка: упаковка 20, ориентир 129 руб с Пэй из индекса
GH | Мягкий держатель гитары (кандидат) | 1 шт | Открыть (https://www.ozon.ru/product/gitarnyy-kryuchok-veshalka-nastennyy-neskolzyashchiy-derzhatel-podstavka-dlya-gitary-ukulele-2675654515/) | 335–353 руб из индекса; НЕ проверена посадка на A и совместимость с покрытием гитары
M5 | Болт M5, шайбы, гайки держателя | 2 компл | Открыть (https://market.yandex.ru/search?text=болт+М5+гайка+шайба) | Длину выбрать по толщине основания держателя + 16 мм плашки + шайбы/гайка; не выпускать до выбора GH
HK | Крючок для наушников на струбцине | 1 шт | Открыть (https://www.ozon.ru/search/?text=держатель+наушников+струбцина+16+мм) | Поиск; зажим должен принимать столешницу 16 мм, мягкие накладки; без сверления корпуса
ED | ПВХ кромка 0,4 мм | 22.0 м с 10% запасом | Открыть (https://market.yandex.ru/search?text=кромка+ПВХ+0.4+22+мм) | Декор в цвет; обработка на производстве
SE | Герметизация торцов прорезей | 1 операция | Открыть (https://market.yandex.ru/search?text=кромка+для+ЛДСП) | Производственный расходник согласовать с технологом; открытый торец не оставлять

## Не покупаем

Телескопические направляющие, петли, доводчики, магнитные замки и покупную ручку: в этой конструкции их нет.

## Хранение мелочей

1. Съёмный лоток 200×100×25 на столешнице сбоку ноутбука: самый простой. 2. Подвесной лоток под передним краем: беречь доступ к ручкам Katana. 3. Узкий лоток на верхней задней надставке: проверить экран. Это опции компоновки, не включены в деталировку D1.
