boxforkonstantin-max/guitar-stand/ldsp-onstage/output-d2/details.dxf

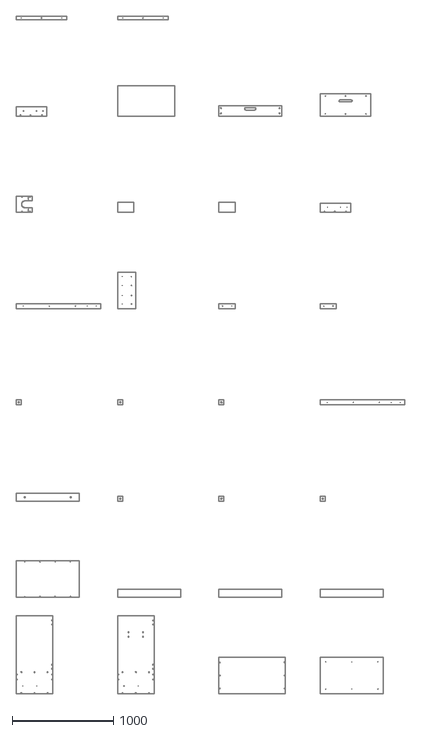
[picture p38: CAD file, 2026-10-12]
ldsp-onstage/output-d2/details.dxf
3834.0 x 6685.0
