boxforkonstantin-max/guitar-stand/ldsp-onstage/output-d3/details.dxf

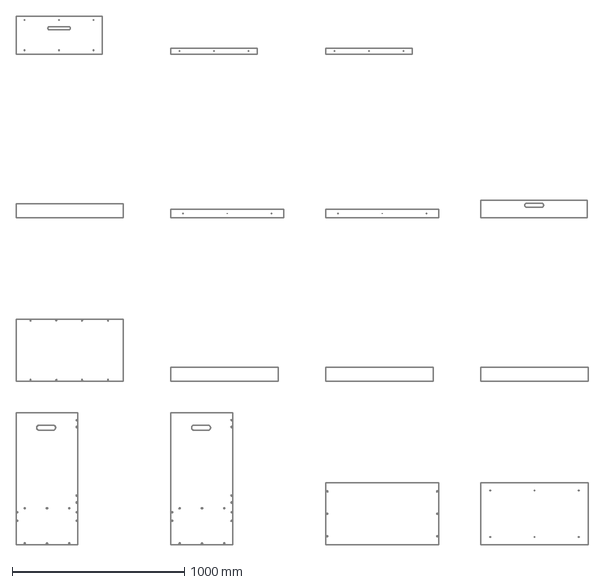
[picture p39: CAD file, 2026-10-12]
ldsp-onstage/output-d3/details.dxf
3322.0 x 3070.0 mm
