boxforkonstantin-max/guitar-stand/output/guitar_stand_parts_arc.dxf

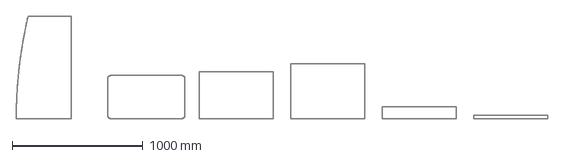
[picture p41: CAD file, 2026-10-10]
output/guitar_stand_parts_arc.dxf
4066.0 x 782.0 mm
