boxforkonstantin-max/guitar-stand/output/guitar_stand_parts.dxf

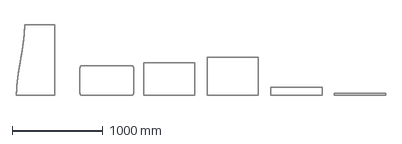
[picture p42: CAD file, 2026-10-10]
output/guitar_stand_parts.dxf
4066.0 x 782.0 mm
