boxforkonstantin-max/guitar-stand/output/guitar_stand_layout_2440x1220_arc.dxf

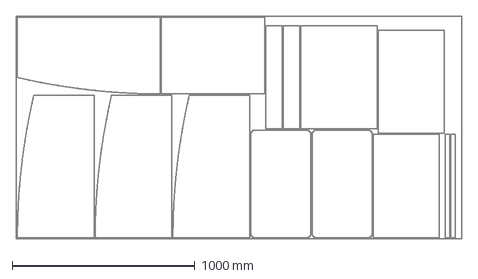
[picture p43: CAD file, 2026-10-10]
output/guitar_stand_layout_2440x1220_arc.dxf
2440.0 x 1220.0 mm
