boxforkonstantin-max/guitar-stand/output/guitar_stand_parts_lean.dxf

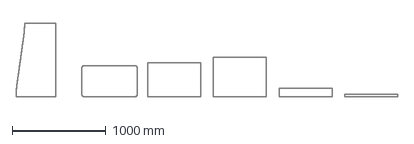
[picture p45: CAD file, 2026-10-10]
output/guitar_stand_parts_lean.dxf
4066.0 x 782.0 mm
