boxforkonstantin-max/guitar-stand/ldsp-onstage/output/details.dxf

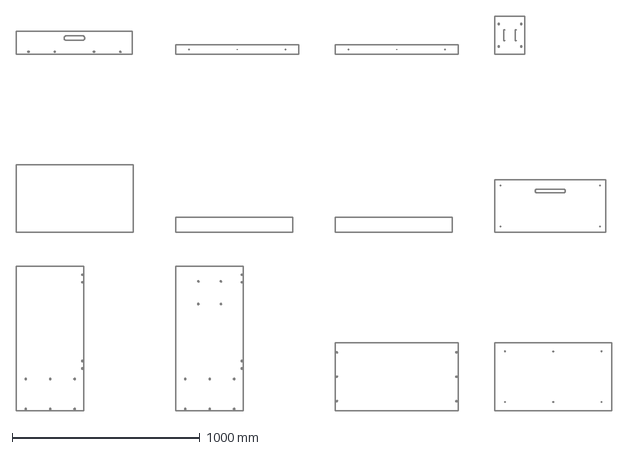
[picture p46: CAD file, 2026-10-11, an earlier design]
ldsp-onstage/output/details.dxf
3172.0 x 2100.0 mm
