boxforkonstantin-max/guitar-stand/cad/guitar_stand.scad

// R5. Millimetres. Nominal assembly; dado machining not modelled.
multmatrix([[0, 0, 1, 572], [0, 1, 0, 0], [1, 0, 0, 0], [0, 0, 0, 1]]) linear_extrude(height=18) polygon([[0.0, 0.0], [0.010503, 4.8875], [0.041836, 9.775], [0.093735, 14.6625], [0.165938, 19.55], [0.258179, 24.4375], [0.370195, 29.325], [0.501724, 34.2125], [0.6525, 39.1], [0.822261, 43.9875], [1.010742, 48.875], [1.217681, 53.7625], [1.442813, 58.65], [1.685874, 63.5375], [1.946602, 68.425], [2.224731, 73.3125], [2.52, 78.2], [2.832144, 83.0875], [3.160898, 87.975], [3.506001, 92.8625], [3.867188, 97.75], [4.244194, 102.6375], [4.636758, 107.525], [5.044614, 112.4125], [5.4675, 117.3], [5.905151, 122.1875], [6.357305, 127.075], [6.823696, 131.9625], [7.304062, 136.85], [7.79814, 141.7375], [8.305664, 146.625], [8.826372, 151.5125], [9.36, 156.4], [9.906284, 161.2875], [10.464961, 166.175], [11.035767, 171.0625], [11.618438, 175.95], [12.21271, 180.8375], [12.81832, 185.725], [13.435005, 190.6125], [14.0625, 195.5], [14.700542, 200.3875], [15.348867, 205.275], [16.007212, 210.1625], [16.675313, 215.05], [17.352905, 219.9375], [18.039727, 224.825], [18.735513, 229.7125], [19.44, 234.6], [20.152925, 239.4875], [20.874023, 244.375], [21.603032, 249.2625], [22.339688, 254.15], [23.083726, 259.0375], [23.834883, 263.925], [24.592896, 268.8125], [25.3575, 273.7], [26.128433, 278.5875], [26.90543, 283.475], [27.688228, 288.3625], [28.476562, 293.25], [29.270171, 298.1375], [30.068789, 303.025], [30.872153, 307.9125], [31.68, 312.8], [32.492065, 317.6875], [33.308086, 322.575], [34.127798, 327.4625], [34.950937, 332.35], [35.777241, 337.2375], [36.606445, 342.125], [37.438286, 347.0125], [38.2725, 351.9], [39.108823, 356.7875], [39.946992, 361.675], [40.786743, 366.5625], [41.627812, 371.45], [42.469937, 376.3375], [43.312852, 381.225], [44.156294, 386.1125], [45.0, 391.0], [45.843706, 395.8875], [46.687148, 400.775], [47.530063, 405.6625], [48.372188, 410.55], [49.213257, 415.4375], [50.053008, 420.325], [50.891177, 425.2125], [51.7275, 430.1], [52.561714, 434.9875], [53.393555, 439.875], [54.222759, 444.7625], [55.049062, 449.65], [55.872202, 454.5375], [56.691914, 459.425], [57.507935, 464.3125], [58.32, 469.2], [59.127847, 474.0875], [59.931211, 478.975], [60.729829, 483.8625], [61.523438, 488.75], [62.311772, 493.6375], [63.09457, 498.525], [63.871567, 503.4125], [64.6425, 508.3], [65.407104, 513.1875], [66.165117, 518.075], [66.916274, 522.9625], [67.660313, 527.85], [68.396968, 532.7375], [69.125977, 537.625], [69.847075, 542.5125], [70.56, 547.4], [71.264487, 552.2875], [71.960273, 557.175], [72.647095, 562.0625], [73.324688, 566.95], [73.992788, 571.8375], [74.651133, 576.725], [75.299458, 581.6125], [75.9375, 586.5], [76.564995, 591.3875], [77.18168, 596.275], [77.78729, 601.1625], [78.381563, 606.05], [78.964233, 610.9375], [79.535039, 615.825], [80.093716, 620.7125], [80.64, 625.6], [81.173628, 630.4875], [81.694336, 635.375], [82.20186, 640.2625], [82.695937, 645.15], [83.176304, 650.0375], [83.642695, 654.925], [84.094849, 659.8125], [84.5325, 664.7], [84.955386, 669.5875], [85.363242, 674.475], [85.755806, 679.3625], [86.132812, 684.25], [86.493999, 689.1375], [86.839102, 694.025], [87.167856, 698.9125], [87.48, 703.8], [87.775269, 708.6875], [88.053398, 713.575], [88.314126, 718.4625], [88.557188, 723.35], [88.782319, 728.2375], [88.989258, 733.125], [89.177739, 738.0125], [89.3475, 742.9], [89.498276, 747.7875], [89.629805, 752.675], [89.741821, 757.5625], [89.834063, 762.45], [89.906265, 767.3375], [89.958164, 772.225], [89.989497, 777.1125], [90.0, 782.0], [420, 782], [420, 0]]);
multmatrix([[0, 0, 1, 0], [0, 1, 0, 0], [1, 0, 0, 0], [0, 0, 0, 1]]) linear_extrude(height=18) polygon([[0.0, 0.0], [0.010503, 4.8875], [0.041836, 9.775], [0.093735, 14.6625], [0.165938, 19.55], [0.258179, 24.4375], [0.370195, 29.325], [0.501724, 34.2125], [0.6525, 39.1], [0.822261, 43.9875], [1.010742, 48.875], [1.217681, 53.7625], [1.442813, 58.65], [1.685874, 63.5375], [1.946602, 68.425], [2.224731, 73.3125], [2.52, 78.2], [2.832144, 83.0875], [3.160898, 87.975], [3.506001, 92.8625], [3.867188, 97.75], [4.244194, 102.6375], [4.636758, 107.525], [5.044614, 112.4125], [5.4675, 117.3], [5.905151, 122.1875], [6.357305, 127.075], [6.823696, 131.9625], [7.304062, 136.85], [7.79814, 141.7375], [8.305664, 146.625], [8.826372, 151.5125], [9.36, 156.4], [9.906284, 161.2875], [10.464961, 166.175], [11.035767, 171.0625], [11.618438, 175.95], [12.21271, 180.8375], [12.81832, 185.725], [13.435005, 190.6125], [14.0625, 195.5], [14.700542, 200.3875], [15.348867, 205.275], [16.007212, 210.1625], [16.675313, 215.05], [17.352905, 219.9375], [18.039727, 224.825], [18.735513, 229.7125], [19.44, 234.6], [20.152925, 239.4875], [20.874023, 244.375], [21.603032, 249.2625], [22.339688, 254.15], [23.083726, 259.0375], [23.834883, 263.925], [24.592896, 268.8125], [25.3575, 273.7], [26.128433, 278.5875], [26.90543, 283.475], [27.688228, 288.3625], [28.476562, 293.25], [29.270171, 298.1375], [30.068789, 303.025], [30.872153, 307.9125], [31.68, 312.8], [32.492065, 317.6875], [33.308086, 322.575], [34.127798, 327.4625], [34.950937, 332.35], [35.777241, 337.2375], [36.606445, 342.125], [37.438286, 347.0125], [38.2725, 351.9], [39.108823, 356.7875], [39.946992, 361.675], [40.786743, 366.5625], [41.627812, 371.45], [42.469937, 376.3375], [43.312852, 381.225], [44.156294, 386.1125], [45.0, 391.0], [45.843706, 395.8875], [46.687148, 400.775], [47.530063, 405.6625], [48.372188, 410.55], [49.213257, 415.4375], [50.053008, 420.325], [50.891177, 425.2125], [51.7275, 430.1], [52.561714, 434.9875], [53.393555, 439.875], [54.222759, 444.7625], [55.049062, 449.65], [55.872202, 454.5375], [56.691914, 459.425], [57.507935, 464.3125], [58.32, 469.2], [59.127847, 474.0875], [59.931211, 478.975], [60.729829, 483.8625], [61.523438, 488.75], [62.311772, 493.6375], [63.09457, 498.525], [63.871567, 503.4125], [64.6425, 508.3], [65.407104, 513.1875], [66.165117, 518.075], [66.916274, 522.9625], [67.660313, 527.85], [68.396968, 532.7375], [69.125977, 537.625], [69.847075, 542.5125], [70.56, 547.4], [71.264487, 552.2875], [71.960273, 557.175], [72.647095, 562.0625], [73.324688, 566.95], [73.992788, 571.8375], [74.651133, 576.725], [75.299458, 581.6125], [75.9375, 586.5], [76.564995, 591.3875], [77.18168, 596.275], [77.78729, 601.1625], [78.381563, 606.05], [78.964233, 610.9375], [79.535039, 615.825], [80.093716, 620.7125], [80.64, 625.6], [81.173628, 630.4875], [81.694336, 635.375], [82.20186, 640.2625], [82.695937, 645.15], [83.176304, 650.0375], [83.642695, 654.925], [84.094849, 659.8125], [84.5325, 664.7], [84.955386, 669.5875], [85.363242, 674.475], [85.755806, 679.3625], [86.132812, 684.25], [86.493999, 689.1375], [86.839102, 694.025], [87.167856, 698.9125], [87.48, 703.8], [87.775269, 708.6875], [88.053398, 713.575], [88.314126, 718.4625], [88.557188, 723.35], [88.782319, 728.2375], [88.989258, 733.125], [89.177739, 738.0125], [89.3475, 742.9], [89.498276, 747.7875], [89.629805, 752.675], [89.741821, 757.5625], [89.834063, 762.45], [89.906265, 767.3375], [89.958164, 772.225], [89.989497, 777.1125], [90.0, 782.0], [420, 782], [420, 0]]);
multmatrix([[1, 0, 0, 0.0], [0, -0.0, 1.0, 782.0], [0, 1.0, 0.0, 90.0], [0, 0, 0, 1]]) linear_extrude(height=18) polygon([[0.0, 24.0], [0.115567, 21.647589], [0.461153, 19.317832], [1.033432, 17.033168], [1.826891, 14.815598], [2.83389, 12.686478], [4.044729, 10.666314], [5.447749, 8.774561], [7.029437, 7.029437], [8.774561, 5.447749], [10.666314, 4.044729], [12.686478, 2.83389], [14.815598, 1.826891], [17.033168, 1.033432], [19.317832, 0.461153], [21.647589, 0.115567], [24.0, 0.0], [566.0, 0.0], [568.352411, 0.115567], [570.682168, 0.461153], [572.966832, 1.033432], [575.184402, 1.826891], [577.313522, 2.83389], [579.333686, 4.044729], [581.225439, 5.447749], [582.970563, 7.029437], [584.552251, 8.774561], [585.955271, 10.666314], [587.16611, 12.686478], [588.173109, 14.815598], [588.966568, 17.033168], [589.538847, 19.317832], [589.884433, 21.647589], [590.0, 24.0], [590.0, 306.0], [589.884433, 308.352411], [589.538847, 310.682168], [588.966568, 312.966832], [588.173109, 315.184402], [587.16611, 317.313522], [585.955271, 319.333686], [584.552251, 321.225439], [582.970563, 322.970563], [581.225439, 324.552251], [579.333686, 325.955271], [577.313522, 327.16611], [575.184402, 328.173109], [572.966832, 328.966568], [570.682168, 329.538847], [568.352411, 329.884433], [566.0, 330.0], [24.0, 330.0], [21.647589, 329.884433], [19.317832, 329.538847], [17.033168, 328.966568], [14.815598, 328.173109], [12.686478, 327.16611], [10.666314, 325.955271], [8.774561, 324.552251], [7.029437, 322.970563], [5.447749, 321.225439], [4.044729, 319.333686], [2.83389, 317.313522], [1.826891, 315.184402], [1.033432, 312.966832], [0.461153, 310.682168], [0.115567, 308.352411], [0.0, 306.0]]);
multmatrix([[1, 0, 0, 12.0], [0, -0.0, 1.0, 242.0], [0, 1.0, 0.0, 50.0], [0, 0, 0, 1]]) linear_extrude(height=18) polygon([[0, 0], [566, 0], [566, 360], [0, 360]]);
multmatrix([[1, 0, 0, 12.0], [0, 0.17364817766693033, 0.984807753012208, 44.67061291283476], [0, 0.984807753012208, -0.17364817766693033, 4.7532054664386845], [0, 0, 0, 1]]) linear_extrude(height=18) polygon([[0, 0], [566, 0], [566, 420], [0, 420]]);
multmatrix([[1, 0, 0, 12.0], [0, 1.0, -0.0, 15.0], [0, 0.0, 1.0, 400.0], [0, 0, 0, 1]]) linear_extrude(height=18) polygon([[0, 0], [566, 0], [566, 90], [0, 90]]);
multmatrix([[1, 0, 0, 12.0], [0, 1.0, -0.0, 260.0], [0, 0.0, 1.0, 50.0], [0, 0, 0, 1]]) linear_extrude(height=18) polygon([[0, 0], [566, 0], [566, 25], [0, 25]]);
