boxforkonstantin-max/guitar-stand/(list of files, cad)

Other CAD files:
ldsp-onstage/output/assembly.scad
cad/guitar_stand_arc.scad
cad/guitar_stand_lean.scad
