boxforkonstantin-max/guitar-stand/ldsp-onstage/CHANGELOG.txt

Pedal options / 2026-10-16
Separate pedal-options.html: option 1 removable board, option 3 pedal fixed to drop flap.
Old R6/D1/D2/D3 files and drawings unchanged. Comparison only, not production release.
Option 3 flap 618x180x16, axis Y34 Z-2, 18mm outside-face runners contact floor at 90 degrees.
Front beam moved to Z90 in this option only; structural validation still required.
91-angle screening: pedal bounds, floor supports and schematic cable route passed.
Cable is illustrative slack, not fixed-length physics; real connector/bend tests required.
Browser: open/close, selection, cutaway and cameras checked; narrow-device test not certified.

D1 / 2026-10-11
Separate LDSP prototype; original R6 files unchanged.
Carcass 654 x 360 x 800 mm, 16 mm LDSP; horizontal amplifier shelf.
Removable floor-supported pedal cassette, no purchased slides/hinges.
12 parts, 36 paired joints, 84 drilling operations, 30 confirmats.
build.py is the source for model.json, PDF, DXF, OpenSCAD and hardware list.
Checked entry faces, hole bounds/depth, paired drilling axes and quantities.
Rendered and visually reviewed all 17 PDF pages.
Interactive viewer: centre-pivot part transforms, exploded view, cassette removal.
NOT RELEASED FOR MANUFACTURE: guitar support incomplete (adapter only),
ventilation deferred, stability/load not tested, some hardware only search links.
No claim of exact On-Stage factory reproduction or verified lowest price.
Public target: existing GitHub Pages /ldsp-onstage/; old /app/ preserved.

D2 / 2026-10-12
Separate d2.html and output-d2/; R6 and D1 geometry unchanged.
30 parts in 16 mm LDSP, 80 paired joints, 178 drilling operations.
Actual guitar cradle GB/G1/G2/GN/GC1/GC2 replaces the unused adapter concept.
BOYARD DB4501Zn/300 drawer; pull-slot handle; removable floor pedalboard.
52 confirmats 7x50; 28 pan-head 4x30; 10 pan-head 3.5x16 for slides.
Shelf K top 236 mm, two vertical 622x80x16 ribs: each conservatively checked
for the entire 20 kg design load without assuming composite action.
Concrete-wall fixing: 2 SXRL10x160FUS, 6 spacers, washers; site validation required.
One 2500x1830 sheet, 4 mm kerf and 10 mm trim. Geometry and export checks pass.
Real SKU links, dated prices, package quantities and manufacturing budget;
not a quotation; anchor split-pack availability and delivery not confirmed.
Independent checks caught and corrected crossing holes in guitar gussets and
insufficient material between the cable slot and a pedalboard screw.
47-page PDF: dimensions, hole entry faces/depths, connections, nesting, estimates.
Release is FIRST_ARTICLE_ONLY: actual slide template, wall substrate, board
certificate, joint proof tests and guitar fit remain physical acceptance gates.
Ventilation explicitly deferred by owner. No claim of certified load capacity.
Source: d2_geometry.py; exports: d2_build.py; verification: d2_verify.py.
D3 / 12.10.2026 / correction requested by owner
- Inspected official detail photos 48143, 48144, 48145, 48146: padded screw-on supports, recessed handles, separate removable pedalboard and bottom door.
- D2 rejected. D3 removes telescopic drawer, wooden neck fork, braces and oversized guitar plinth. Body retained 654x360x800, 15 wood parts; two 110x30 side hand openings.
- Drop-front 0..90 degrees, separate lift/pull/lower pedalboard sequence. No slide hardware. 91-angle sweep check; 18 mm floor clearance, 8 mm lifted-foot clearance, 21 mm pedal clearance under front rib.
- Exact hardware template remains HOLD. 108 core drillings documented; no invented holder/hinge holes. PDF 20 pages and DXF are review files, not full production authorization.
- Krepika live catalogue: 6725 7x50 at 1.98 RUB/unit; 7312 4x30 at 1273.96 RUB/kg; 1575 3.5x16 at 519 RUB/kg; 1794 M10 washer 3.74 RUB/unit. No bulk packs or rubber roll. Reserve-based total 13420.04 RUB, hardware 2305.08, not a seller quote.
- Static hosting reliability: vendored same-version Three.js, visible import failure message in R6/D3, permanent HTTPS links. R6 geometry and JavaScript unchanged.
