boxforkonstantin-max/guitar-stand/(commit log)

2026-10-10 Publish R5 guitar stand review with forward Katana tilt
    [guitar_stand.scad, guitar_stand_arc.scad, guitar_stand_layout_2440x1220.dxf, guitar_stand_layout_2440x1220_arc.dxf, guitar_stand_layout_2440x1220_lean.dxf, guitar_stand_lean.scad, guitar_stand_parts.dxf, guitar_stand_parts_arc.dxf]
2026-10-10 Restore horizontal Katana shelf and amplifier in R6
    [guitar_stand.scad, guitar_stand_arc.scad, guitar_stand_lean.scad]
2026-10-11 Add separate LDSP D1 model, drilling drawings and hardware reference
    [assembly.scad, details.dxf]
2026-10-12 Add D2 guitar cradle, real drawer mechanism, drilling package and costed hardware
    [assembly.scad, details.dxf, drilling.csv]
2026-10-12 D3: replace drawer with drop-front, padded support layout and local hardware costs; vendor 3D runtime
    [details.dxf, drilling.csv]
2026-10-12 Show soft neck retention strap in D3 layout
